ucandevices/IO-LINK-Covnerter/pcb/IO_link.png

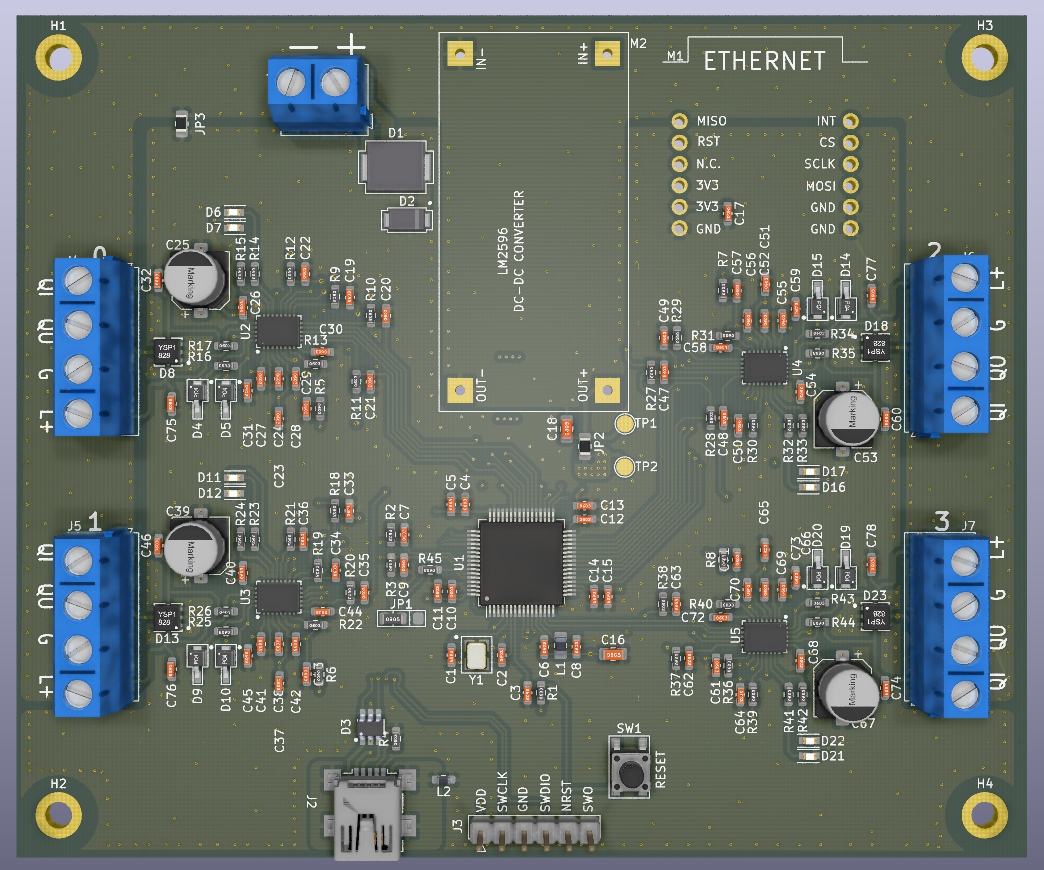
pcb/IO_link.png
