ucandevices/IO-LINK-Covnerter/firmware/IOLINK_MASTER/README.md

# IO-LINK_TEST

'0' - reset all devices
'1' - SIO dev 0
'2' - IO-LINK dev 0
'3' - SIO dev 1
'4' - IO-LINK dev 1
...
'8' - IO-LINK dev 3
other - reset STM

Przykład widoku konsoli dla '8':
                                                                                
Start Program                                                                   

Power up dev 3 CORRECT                                                          
Wake up dev 3 CORRECT - BAUD 2                                                  
-----Car$l!o Gav6azzi"?-                                                        
INIT DEV 3 DONE                                                                 
                                                                                
--------------------------------<<<<<<<<<<<<<<<-------------------              
                                                                       
,gdzie - to czujnik bez kontaktu, < przyłożone coś do czujnika
