ucandevices/IO-LINK-Covnerter/pcb/IO_LINK_LIB/STEP_FILES/Ferrite_Bead_0603.STEP

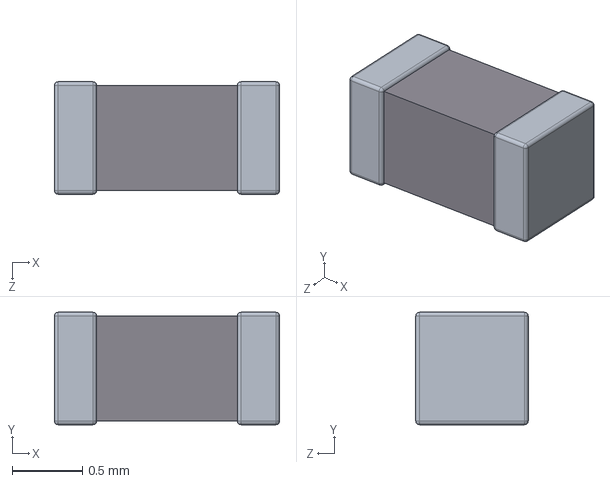
[picture p2: CAD file, 2021-03-06]
pcb/IO_LINK_LIB/STEP_FILES/Ferrite_Bead_0603.STEP
1.60 x 0.8 x 0.8 mm
