ucandevices/IO-LINK-Covnerter/pcb/IO_LINK_LIB/STEP_FILES/Coilcraft-MSS1210.step

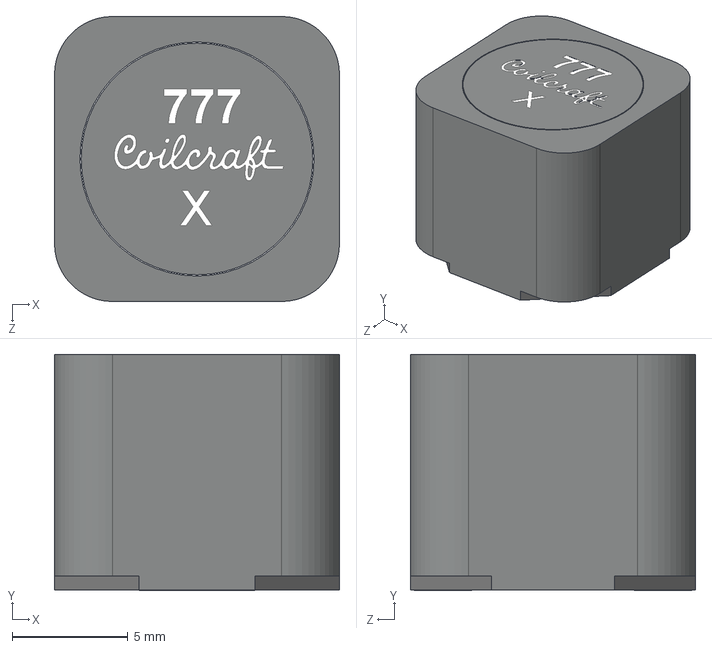
[picture p3: CAD file, 2021-03-06]
pcb/IO_LINK_LIB/STEP_FILES/Coilcraft-MSS1210.step
12.3 x 10.2 x 12.3 mm
