ucandevices/IO-LINK-Covnerter/pcb/IO_LINK_LIB/STEP_FILES/Resistor_0603.step

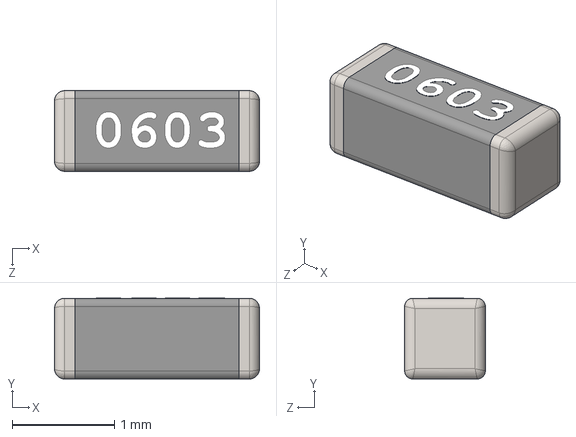
[picture p4: CAD file, 2021-03-06]
pcb/IO_LINK_LIB/STEP_FILES/Resistor_0603.step
2.00 x 0.79 x 0.787 mm
