ucandevices/IO-LINK-Covnerter/pcb/IO_LINK_LIB/STEP_FILES/SPT01-335DEE.step

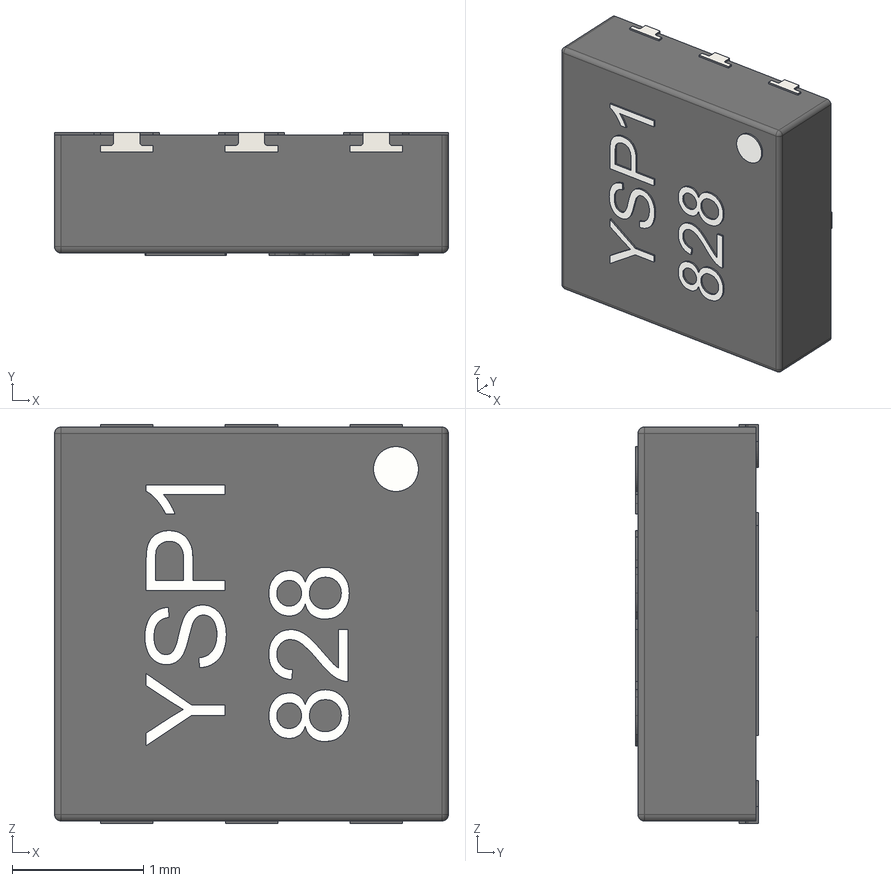
[picture p5: CAD file, 2021-03-06]
pcb/IO_LINK_LIB/STEP_FILES/SPT01-335DEE.step
3.00 x 0.94 x 3.04 mm
