ucandevices/IO-LINK-Covnerter/pcb/IO_LINK_LIB/STEP_FILES/IDC_20.step

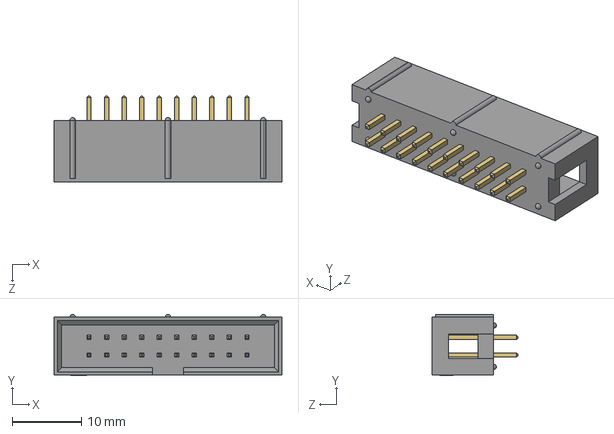
[picture p6: CAD file, 2021-03-06]
pcb/IO_LINK_LIB/STEP_FILES/IDC_20.step
33.0 x 8.85 x 12.4 mm
