ucandevices/IO-LINK-Covnerter/pcb/IO_LINK_LIB/STEP_FILES/ACT45B.step

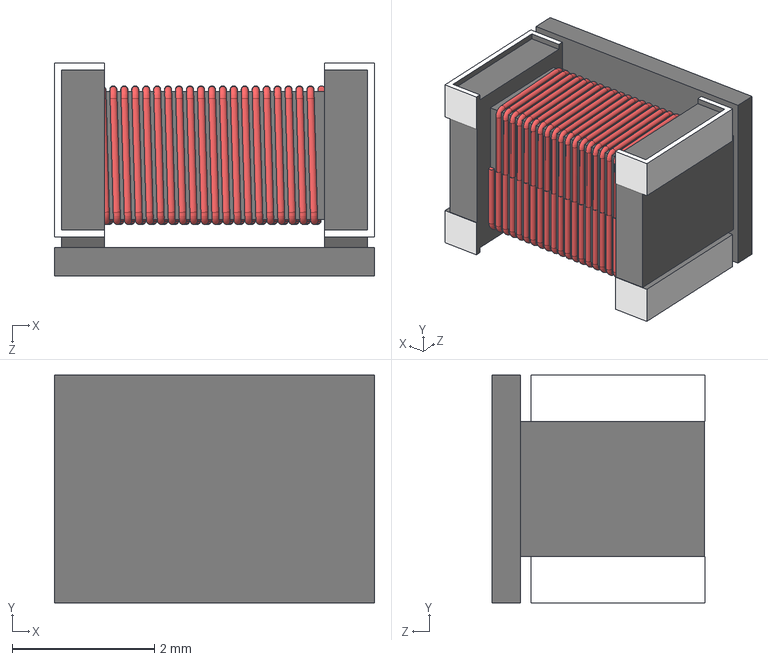
[picture p7: CAD file, 2021-03-06]
pcb/IO_LINK_LIB/STEP_FILES/ACT45B.step
4.50 x 3.20 x 3.00 mm
