ucandevices/IO-LINK-Covnerter/pcb/IO_LINK_LIB/STEP_FILES/WIZNET_W5500.step

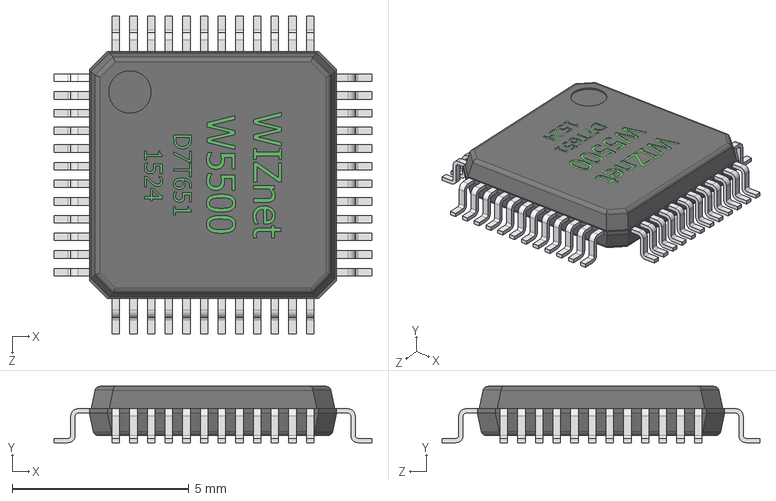
[picture p8: CAD file, 2021-03-06]
pcb/IO_LINK_LIB/STEP_FILES/WIZNET_W5500.step
9.00 x 1.60 x 9.00 mm
