ucandevices/IO-LINK-Covnerter/pcb/IO_LINK_LIB/STEP_FILES/Resistor_1825.step

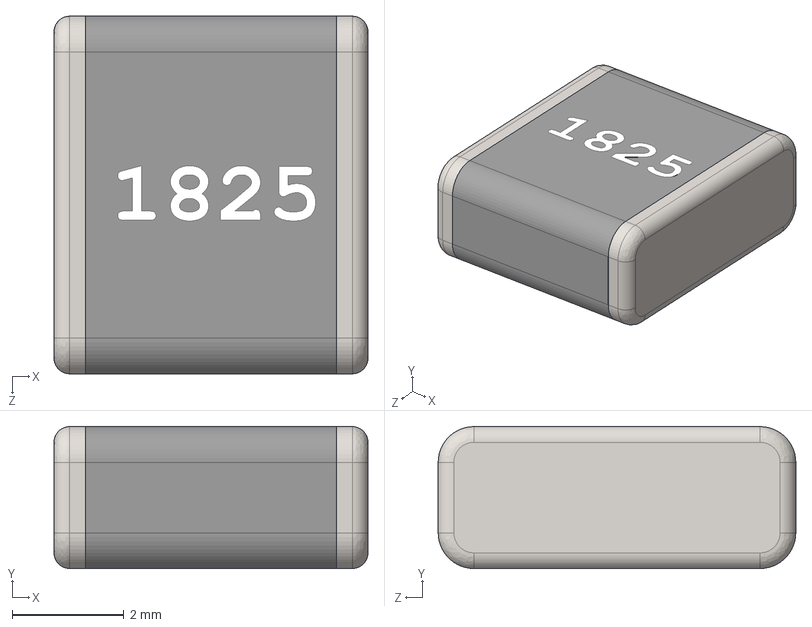
[picture p9: CAD file, 2021-03-06]
pcb/IO_LINK_LIB/STEP_FILES/Resistor_1825.step
5.62 x 2.54 x 6.40 mm
