ucandevices/IO-LINK-Covnerter/pcb/IO_LINK_LIB/STEP_FILES/Resistor_0805.step

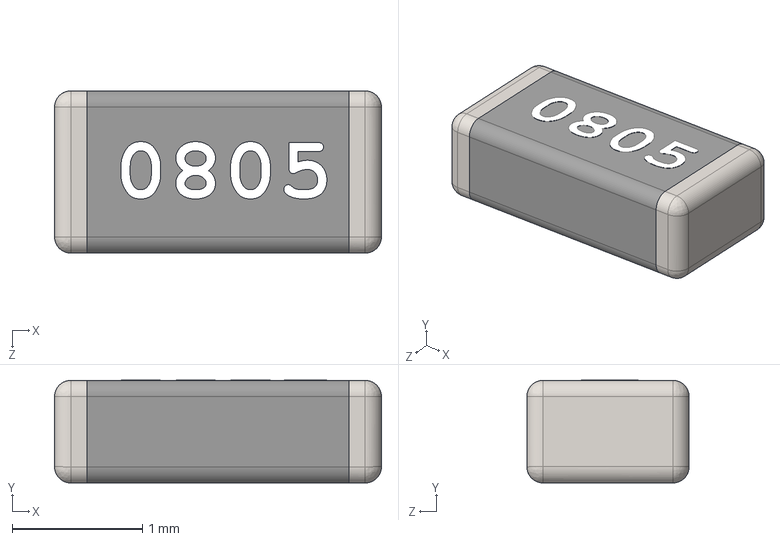
[picture p10: CAD file, 2021-03-06]
pcb/IO_LINK_LIB/STEP_FILES/Resistor_0805.step
2.51 x 0.79 x 1.24 mm
