ucandevices/IO-LINK-Covnerter/pcb/IO_LINK_LIB/STEP_FILES/Tactile_switch.STEP

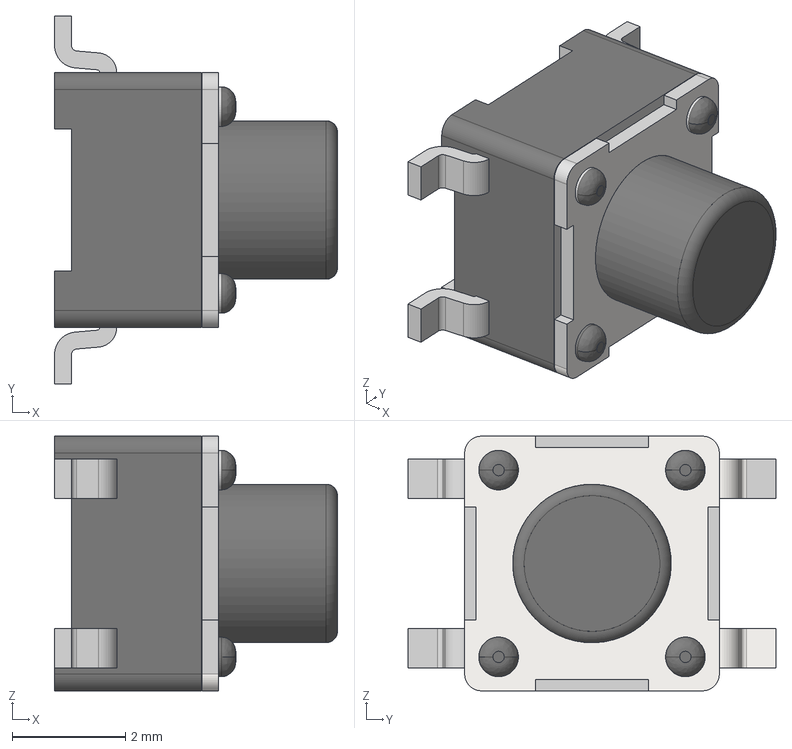
[picture p11: CAD file, 2021-03-06]
pcb/IO_LINK_LIB/STEP_FILES/Tactile_switch.STEP
5.00 x 6.50 x 4.50 mm
