ucandevices/IO-LINK-Covnerter/pcb/IO_LINK_LIB/STEP_FILES/DO-216.step

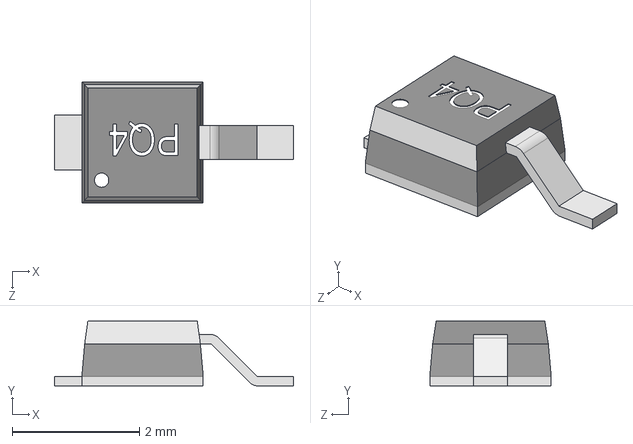
[picture p12: CAD file, 2021-03-06]
pcb/IO_LINK_LIB/STEP_FILES/DO-216.step
3.76 x 1.02 x 1.91 mm
