ucandevices/IO-LINK-Covnerter/pcb/IO_LINK_LIB/STEP_FILES/SO_8.step

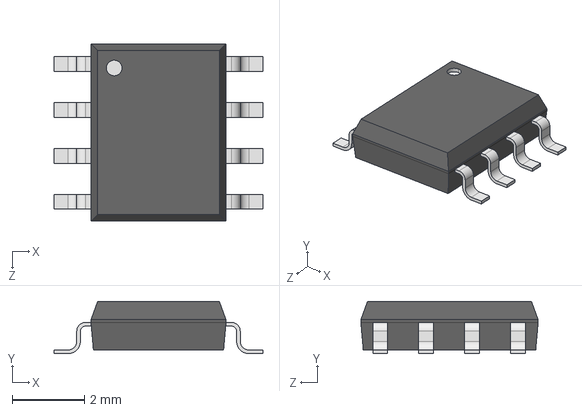
[picture p13: CAD file, 2021-03-06]
pcb/IO_LINK_LIB/STEP_FILES/SO_8.step
5.78 x 1.45 x 4.90 mm
