ucandevices/IO-LINK-Covnerter/pcb/IO_LINK_LIB/STEP_FILES/SMC_DO-214AB_BI_TVS.step

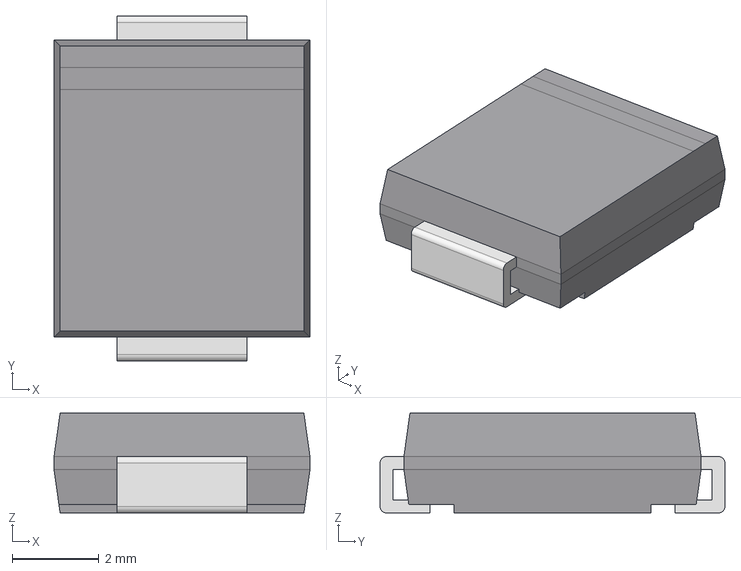
[picture p14: CAD file, 2021-03-06]
pcb/IO_LINK_LIB/STEP_FILES/SMC_DO-214AB_BI_TVS.step
5.90 x 7.95 x 2.30 mm
