ucandevices/IO-LINK-Covnerter/pcb/IO_LINK_LIB/STEP_FILES/COIL_SMD_0805.STEP

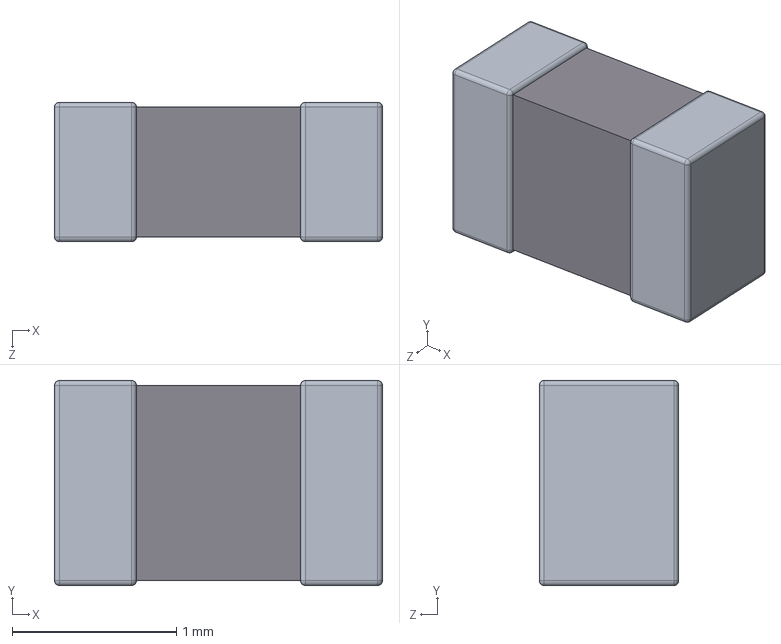
[picture p15: CAD file, 2021-03-06]
pcb/IO_LINK_LIB/STEP_FILES/COIL_SMD_0805.STEP
2.00 x 1.25 x 0.85 mm
