ucandevices/IO-LINK-Covnerter/pcb/IO_LINK_LIB/STEP_FILES/USB_mini_B .step

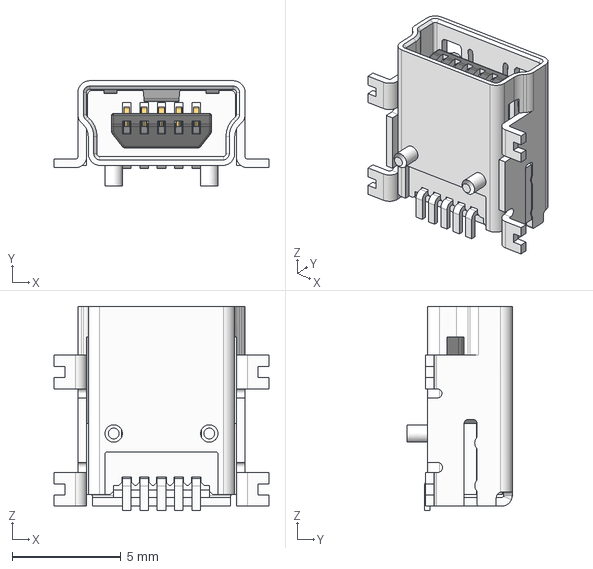
[picture p16: CAD file, 2021-03-06]
pcb/IO_LINK_LIB/STEP_FILES/USB_mini_B .step
9.90 x 5.00 x 9.40 mm
