ucandevices/IO-LINK-Covnerter/pcb/IO_LINK_LIB/STEP_FILES/Crystal_SMD.STEP

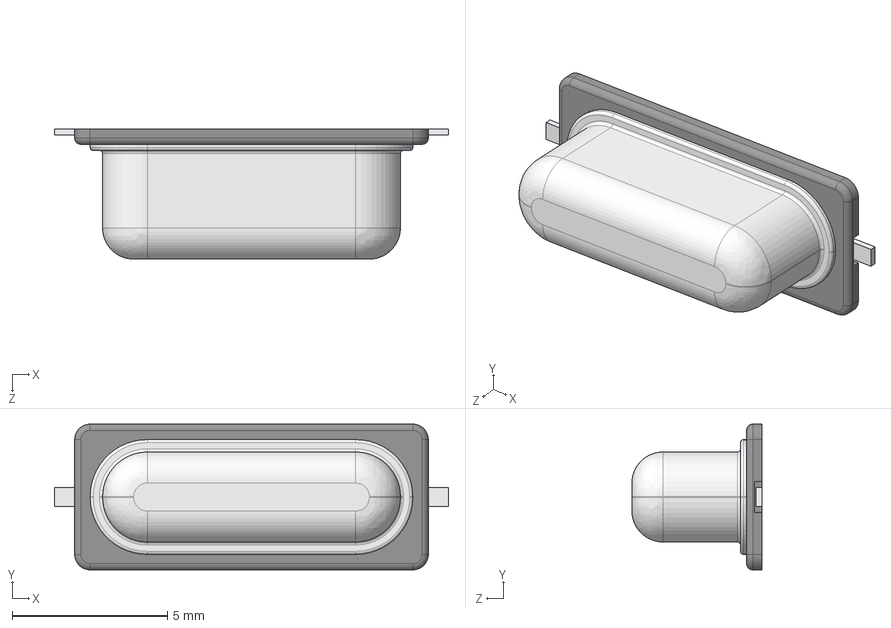
[picture p17: CAD file, 2021-03-06]
pcb/IO_LINK_LIB/STEP_FILES/Crystal_SMD.STEP
12.7 x 4.70 x 4.20 mm
