ucandevices/IO-LINK-Covnerter/pcb/IO_LINK_LIB/STEP_FILES/SOIC_8.step

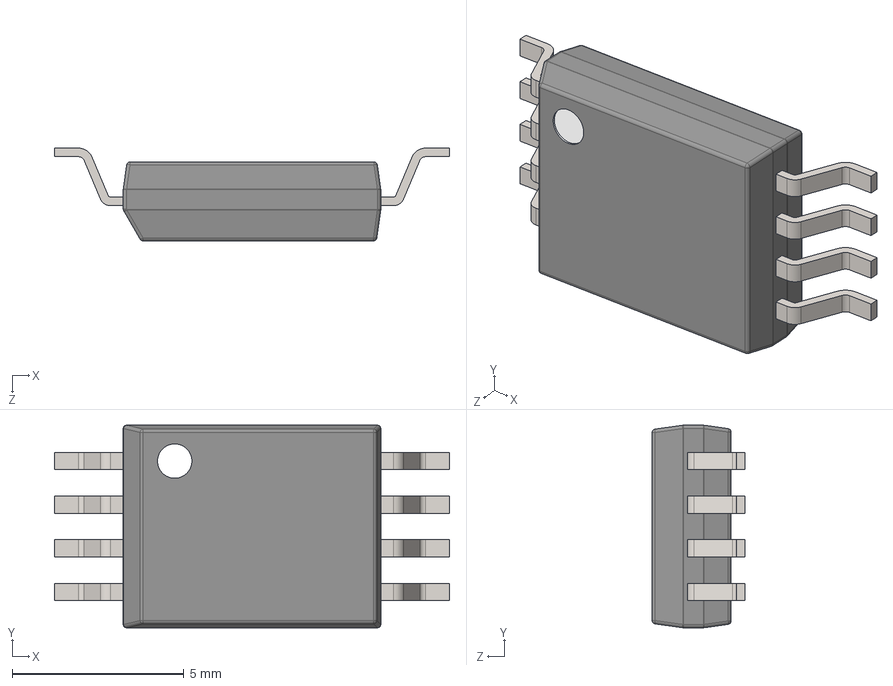
[picture p18: CAD file, 2021-03-06]
pcb/IO_LINK_LIB/STEP_FILES/SOIC_8.step
11.5 x 5.90 x 2.70 mm
