ucandevices/IO-LINK-Covnerter/pcb/IO_LINK_LIB/STEP_FILES/SOT-23-6L.step

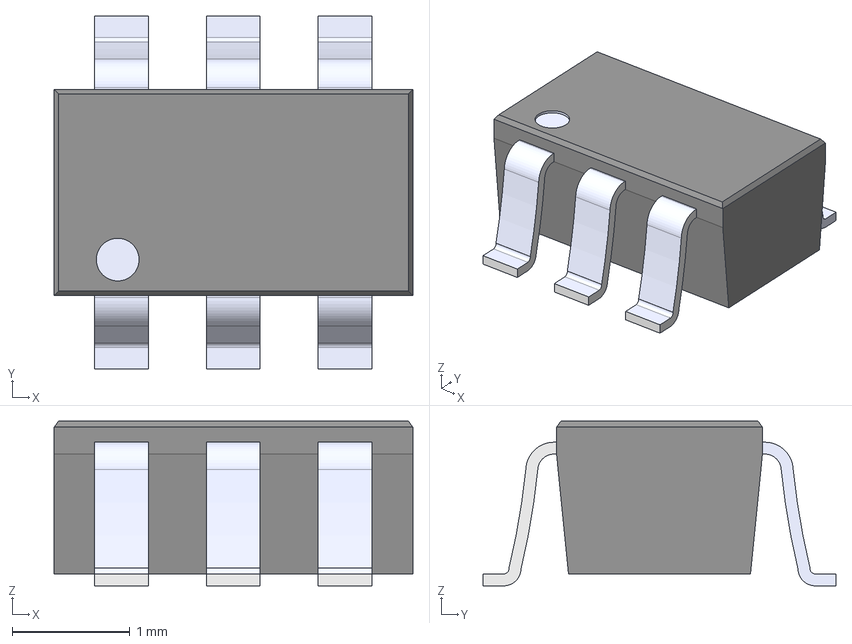
[picture p19: CAD file, 2021-03-06]
pcb/IO_LINK_LIB/STEP_FILES/SOT-23-6L.step
3.05 x 3.00 x 1.40 mm
