ucandevices/IO-LINK-Covnerter/pcb/IO_LINK_LIB/STEP_FILES/SMC_DO-214AB.step

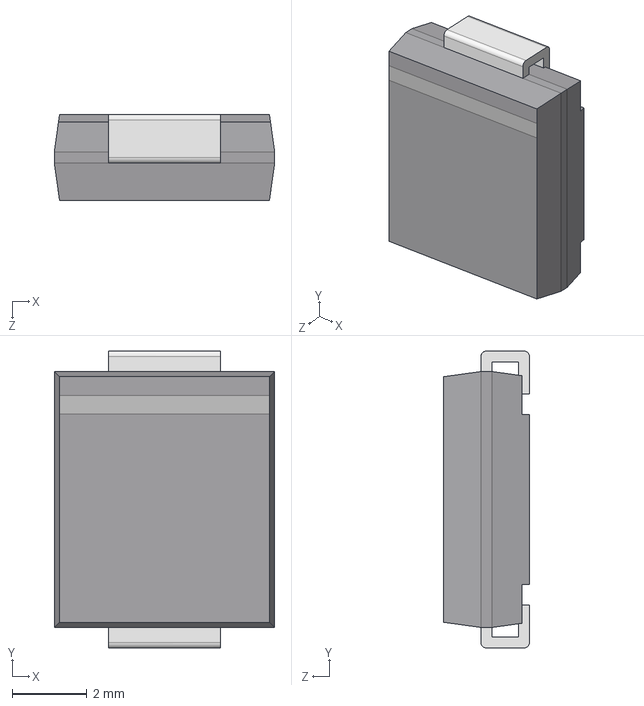
[picture p20: CAD file, 2021-03-06]
pcb/IO_LINK_LIB/STEP_FILES/SMC_DO-214AB.step
5.90 x 7.95 x 2.30 mm
