ucandevices/IO-LINK-Covnerter/pcb/IO_LINK_LIB/STEP_FILES/Electrolytic_Capacitor_6.3mm_x_5.8mm .step

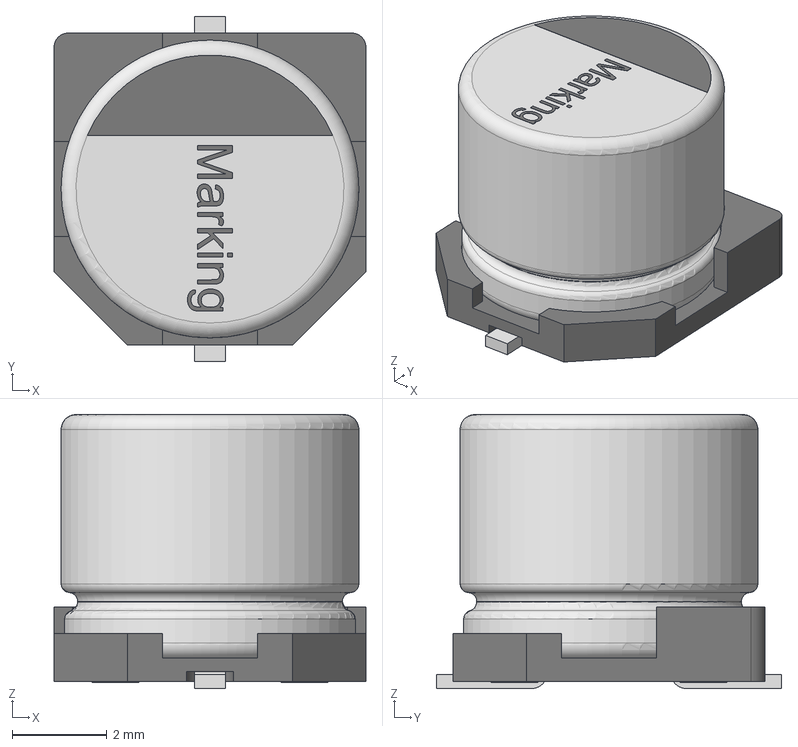
[picture p21: CAD file, 2021-03-06]
pcb/IO_LINK_LIB/STEP_FILES/Electrolytic_Capacitor_6.3mm_x_5.8mm .step
6.60 x 7.30 x 5.81 mm
Base_Φ6_3Capacitor
capicitor_6.3x5.8x2.2
