ucandevices/IO-LINK-Covnerter/pcb/IO_LINK_LIB/STEP_FILES/SOT_23.step

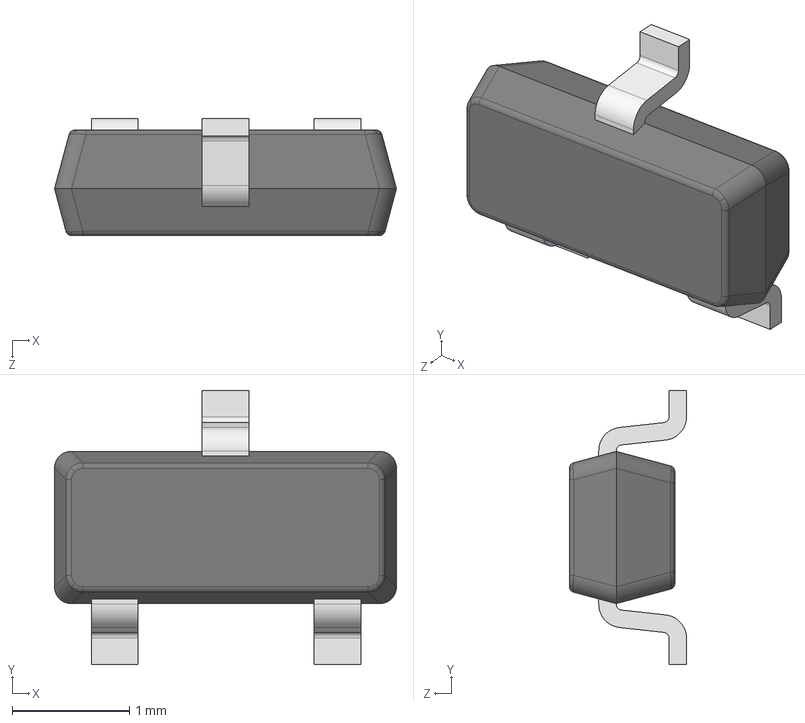
[picture p22: CAD file, 2021-03-06]
pcb/IO_LINK_LIB/STEP_FILES/SOT_23.step
2.92 x 2.34 x 1.00 mm
