ucandevices/IO-LINK-Covnerter/pcb/IO_LINK_LIB/STEP_FILES/Capacitor_1206.step

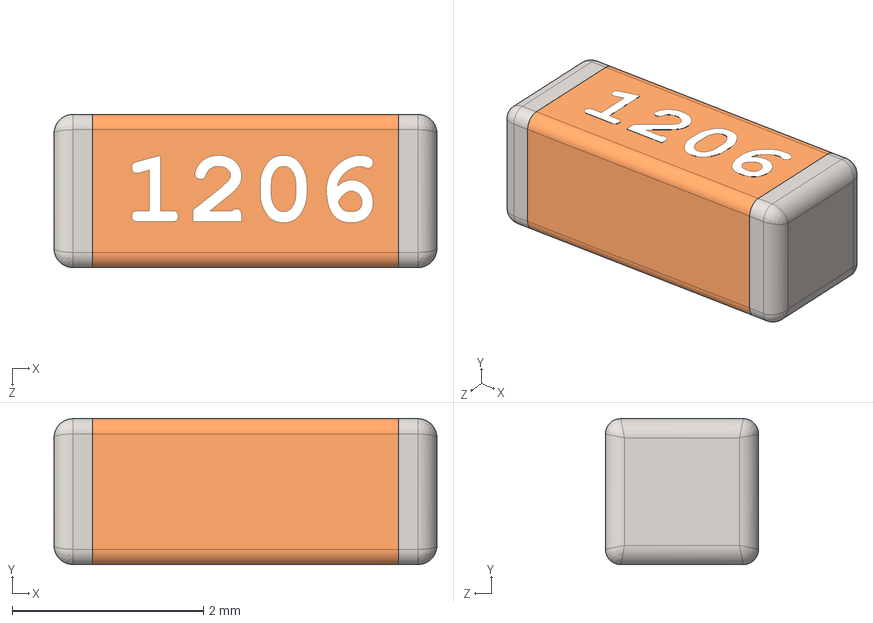
[picture p23: CAD file, 2021-03-06]
pcb/IO_LINK_LIB/STEP_FILES/Capacitor_1206.step
4.00 x 1.53 x 1.60 mm
