ucandevices/IO-LINK-Covnerter/pcb/IO_LINK_LIB/STEP_FILES/SMA_DO214CA.step

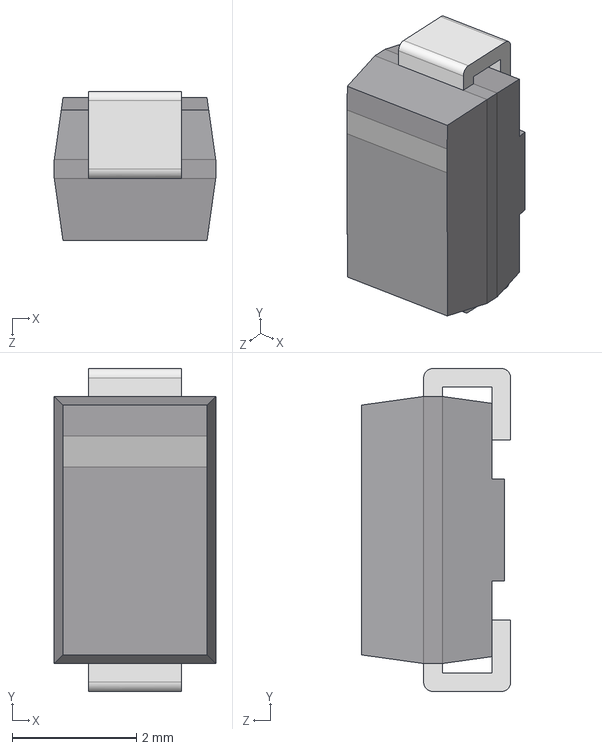
[picture p24: CAD file, 2021-03-06]
pcb/IO_LINK_LIB/STEP_FILES/SMA_DO214CA.step
2.60 x 5.20 x 2.40 mm
