ucandevices/IO-LINK-Covnerter/pcb/IO_LINK_LIB/STEP_FILES/GOLDPIN_1x6_2.54mm.step

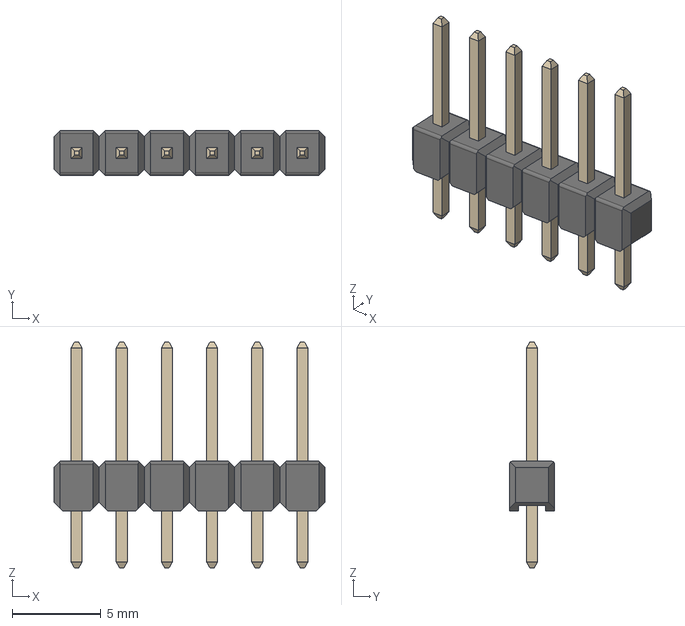
[picture p25: CAD file, 2021-03-06]
pcb/IO_LINK_LIB/STEP_FILES/GOLDPIN_1x6_2.54mm.step
15.2 x 2.54 x 12.7 mm
