ucandevices/IO-LINK-Covnerter/pcb/IO_LINK_LIB/STEP_FILES/LED_0603.step

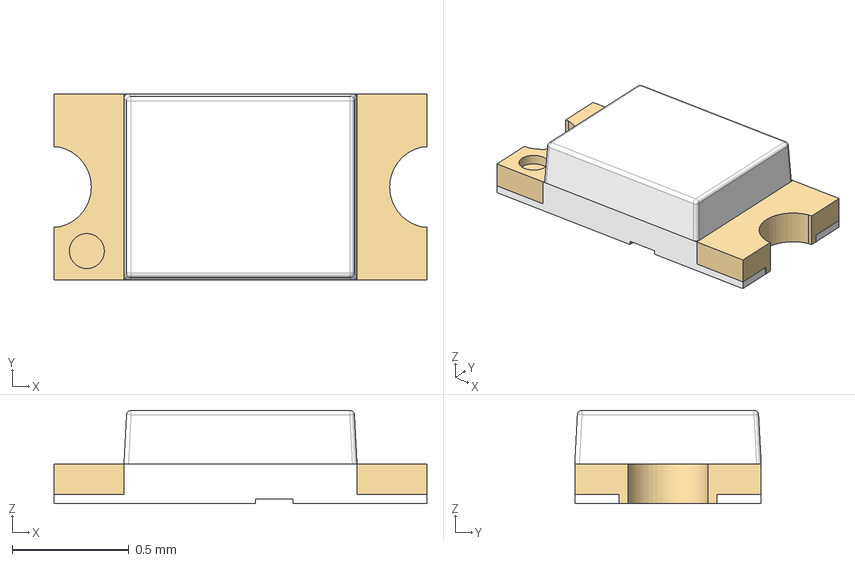
[picture p26: CAD file, 2021-03-06]
pcb/IO_LINK_LIB/STEP_FILES/LED_0603.step
1.60 x 0.8 x 0.4 mm
housing
cover
base-oa0
base
