ucandevices/IO-LINK-Covnerter/pcb/IO_LINK_LIB/STEP_FILES/CRYSTAL_SMD_4pads_3.2x2.5.step

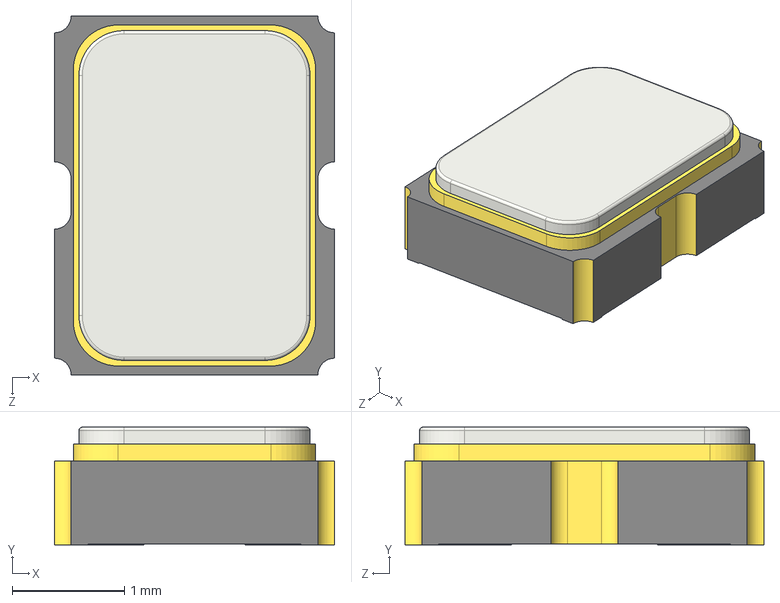
[picture p27: CAD file, 2021-03-06]
pcb/IO_LINK_LIB/STEP_FILES/CRYSTAL_SMD_4pads_3.2x2.5.step
2.50 x 1.05 x 3.20 mm
