ucandevices/IO-LINK-Covnerter/pcb/IO_LINK_LIB/STEP_FILES/L6360TR.step

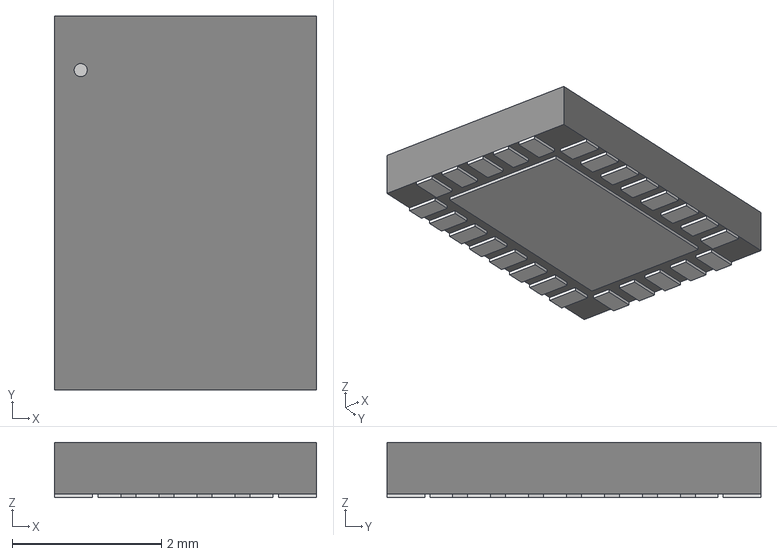
[picture p28: CAD file, 2021-03-06]
pcb/IO_LINK_LIB/STEP_FILES/L6360TR.step
3.51 x 5.00 x 0.739 mm
