ucandevices/IO-LINK-Covnerter/pcb/IO_LINK_LIB/STEP_FILES/HSOP_8.step

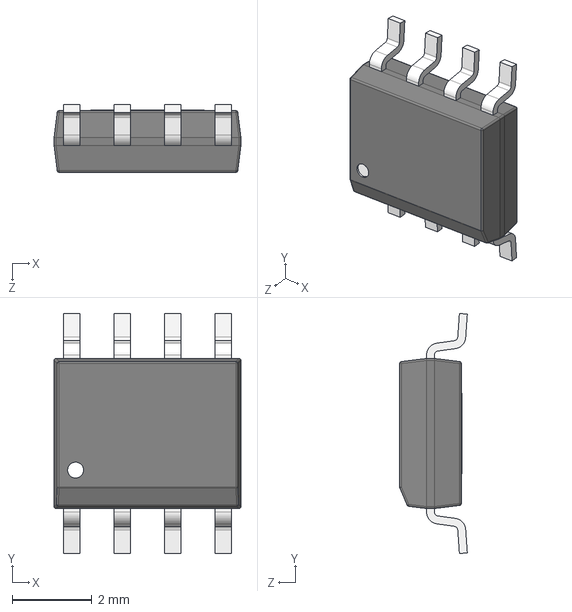
[picture p29: CAD file, 2021-03-06]
pcb/IO_LINK_LIB/STEP_FILES/HSOP_8.step
4.69 x 6.03 x 1.70 mm
