ucandevices/IO-LINK-Covnerter/(list of files, cad)

Other CAD files:
pcb/IO_LINK_LIB/STEP_FILES/Capacitor_0603.step
pcb/IO_LINK_LIB/STEP_FILES/Capacitor_0805.step
pcb/IO_LINK_LIB/STEP_FILES/HR911105A.step
pcb/IO_LINK_LIB/STEP_FILES/Screw_terminal_2way_5.08.step
pcb/IO_LINK_LIB/STEP_FILES/Screw_terminal_3way_5.08.step
pcb/IO_LINK_LIB/STEP_FILES/Screw_terminal_4way_5.step
