ucandevices/IO-LINK-Covnerter/pcb/IO_LINK.kicad_pcb

## KiCad design pcb/IO_LINK.kicad_pcb (2021-06-21)

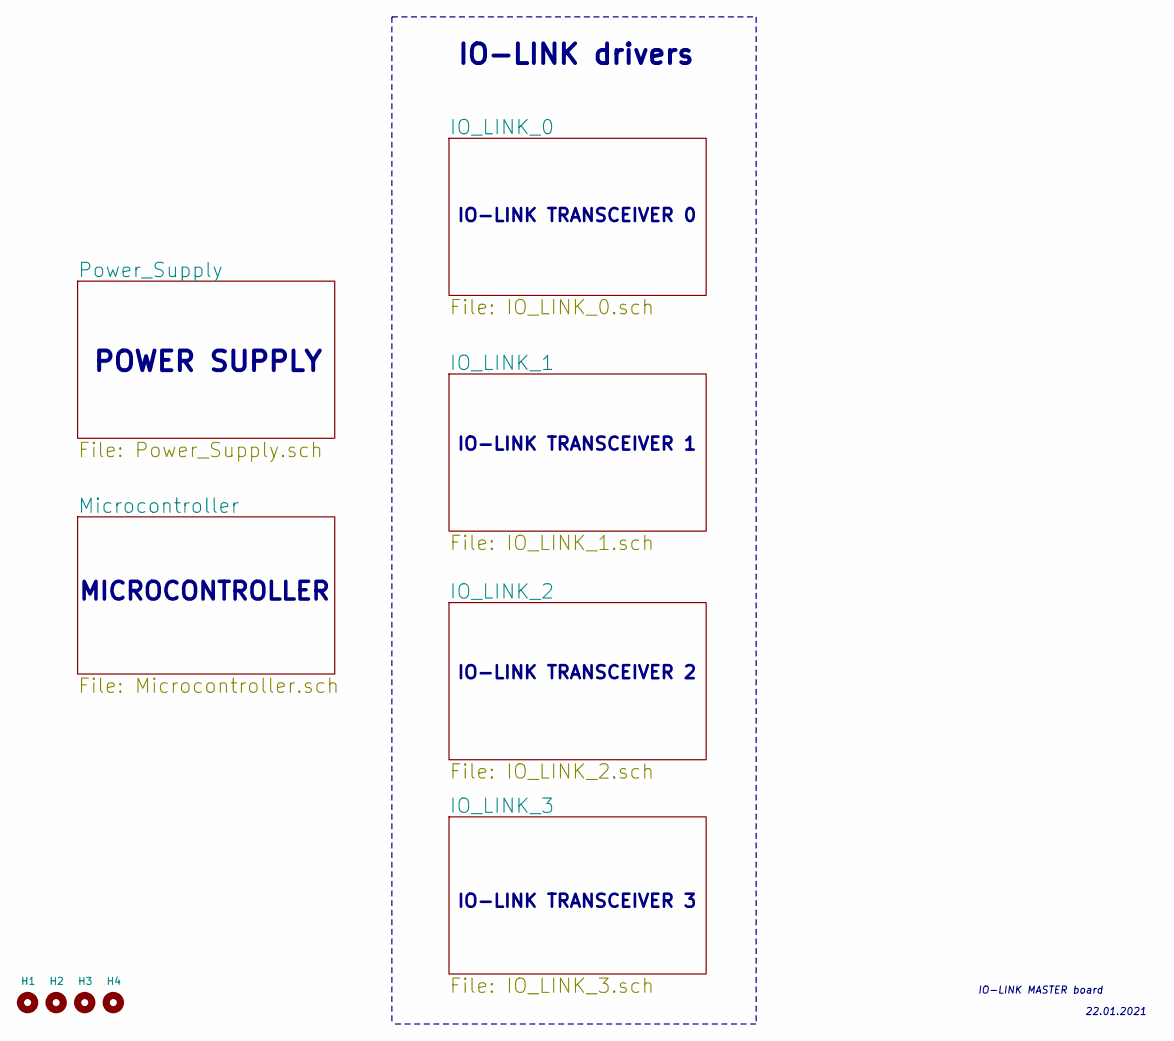
[picture p30: schematic IO_LINK.sch]

Parts:
H1, H2, H3, H4: MountingHole; MountingHole_3.2mm_M3_ISO14580_Pad_TopBottom

Notes on the sheet:
POWER SUPPLY
IO-LINK drivers
MICROCONTROLLER
IO-LINK TRANSCEIVER 0
IO-LINK TRANSCEIVER 1
IO-LINK TRANSCEIVER 2
IO-LINK TRANSCEIVER 3
IO-LINK MASTER board
22.01.2021

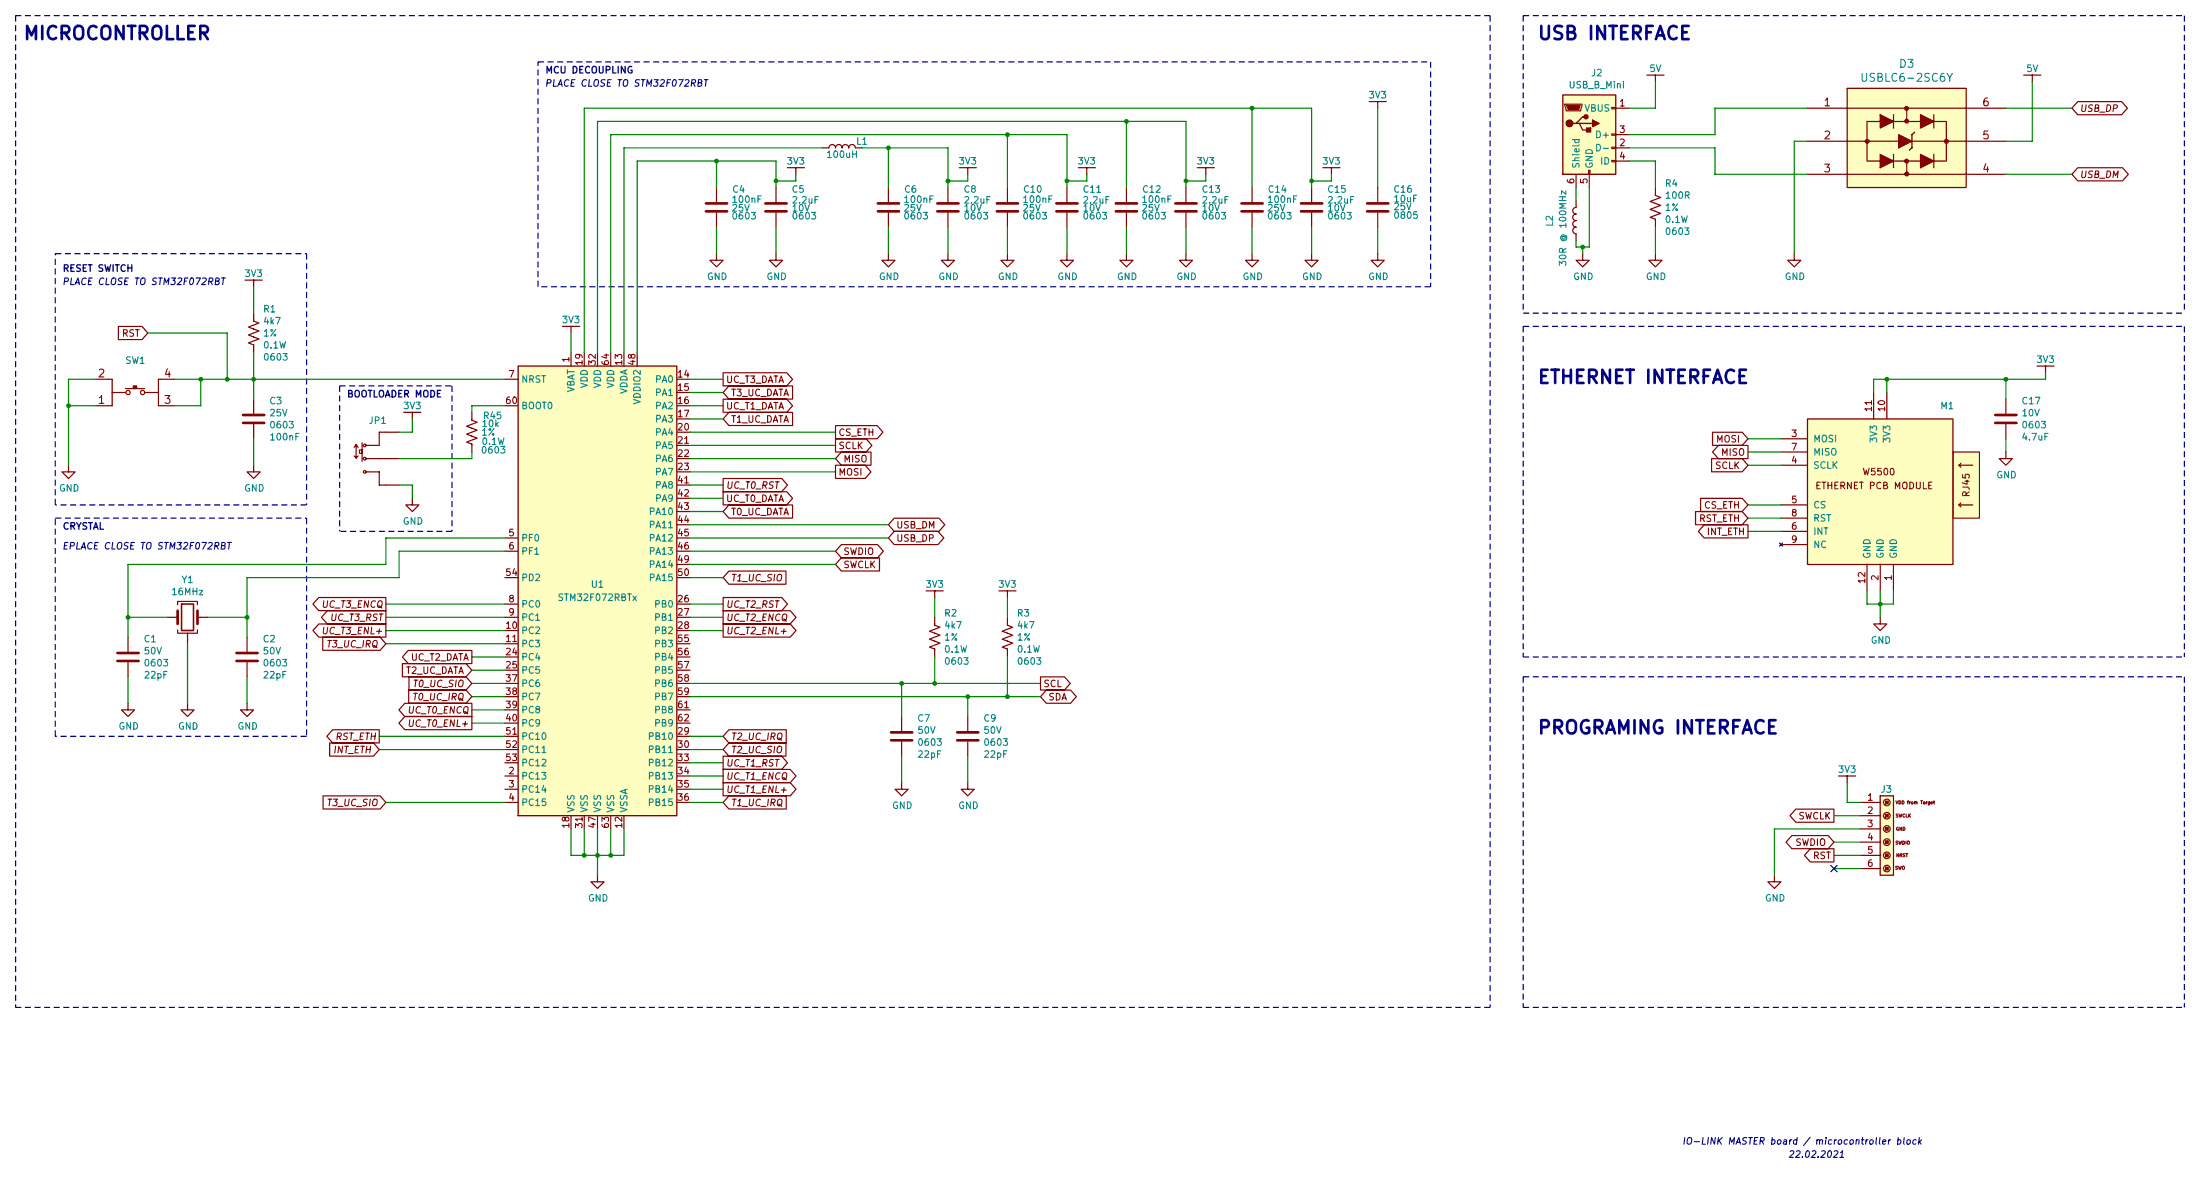
[picture p31: schematic Microcontroller.sch]

Parts:
C1, C2, C7, C9: 22pF_50V_0603; C_0603_1608Metric_Pad1.08x0.95mm_HandSolder; Voltage 50V; MPN CL10C220JB8NNNC; LCSC C1653
C3, C4, C6, C10, C12, C14: 100nF_25V_0603; C_0603_1608Metric_Pad1.08x0.95mm_HandSolder; Voltage 25V; MPN 0603B104K250CT; LCSC C83054
C5, C8, C11, C13, C15: 2.2uF_10V_0603; C_0603_1608Metric_Pad1.08x0.95mm_HandSolder; Voltage 10V; MPN CL10A225KP8NNNC; LCSC C1607
C16: 10uF_25V_0805; C_0805_2012Metric_Pad1.18x1.45mm_HandSolder; Voltage 25V; MPN CL21A106KAYNNNE; LCSC C15850
C17: 4.7uF_10V_0603; C_0603_1608Metric_Pad1.08x0.95mm_HandSolder; Voltage 10V; MPN CL10A475KP8NNNC; LCSC C1705
D3: USBLC6-2SC6Y; SOT-23-6L; MPN USBLC6-2SC6Y; LCSC C435848
J2: USB_B_Mini; USB_Mini-B_Horizontal; MPN 10033526-N3222MLF; LCSC N/A
J3: STM_PROGRAMING_CONNECTOR; MPN T821120A1S100CEU; LCSC N/A
JP1: SOLDERED_SELECTOR; SOLDERABLE_SELECTOR; MPN MCU08050Z0000ZP500; LCSC N/a
L1: Coil_100uH_0805; COIL_0805; MPN KLZ2012NHR101LTD25; LCSC N/A
L2: FB_30R@100MHz; Ferrite_bead_0603; MPN BLM18SP300SZ1D; LCSC N/A
M1: W5500_ETHERNET_PCB_MODULE; W5500_LITE_PCB_MODULE; MPN N/A; LCSC N/A
R1, R2, R3: 4k7_1%_0.1W_0603; R_0603_1608Metric_Pad0.98x0.95mm_HandSolder; Tolerance 1%; MPN 0603WAF4701T5E; LCSC C23162
R4: 100R_1%_0.1W_0603; R_0603_1608Metric_Pad0.98x0.95mm_HandSolder; Tolerance 1%; MPN 0603WAF1000T5E; LCSC C22775
R45: 10k_1%_0.1W_0603; R_0603_1608Metric_Pad0.98x0.95mm_HandSolder; Tolerance 1%; MPN 0603WAF1002T5E; LCSC C25804
SW1: Tactile_Switch; MPN PTS647SN50SMTR2LFS; LCSC N/A
U1: STM32F072RBTx; LQFP-64_10x10mm_P0.5mm
Y1: CRYSTAL_16MHz_4PADS; CRYSTAL_SMD_4PADS_3.2x2.5; MPN X322516MLB4SI; LCSC C13738

Connections:
3V3: C4.1, C5.1, C6.1, C8.1, C10.1, C11.1, C12.1, C13.1, C14.1, C15.1, C16.1, C17.1, J3.1, JP1.1, L1.2, M1.10 (3V3), M1.11 (3V3), R1.1, R2.1, R3.1, U1.1 (VBAT), U1.19 (VDD), U1.32 (VDD), U1.48 (VDDIO2), U1.64 (VDD); also elsewhere on the board
5V: D3.5, J2.1 (VBUS)
CS_ETH: M1.5 (CS), U1.20 (PA4)
GND: C1.2, C2.2, C3.2, C4.2, C5.2, C6.2, C7.2, C8.2, C9.2, C10.2, C11.2, C12.2, C13.2, C14.2, C15.2, C16.2, C17.2, D3.2, J2.5 (GND), J3.3, JP1.3, L2.1, M1.1 (GND), M1.2 (GND), M1.12 (GND), R4.2, SW1.1, SW1.2, U1.12 (VSSA), U1.18 (VSS), U1.31 (VSS), U1.47 (VSS), U1.63 (VSS), Y1.3; also elsewhere on the board
INT_ETH: M1.6 (INT), U1.52 (PC11)
MISO: M1.7 (MISO), U1.22 (PA6)
MOSI: M1.3 (MOSI), U1.23 (PA7)
unnamed: C1.1, U1.5 (PF0), Y1.1
unnamed: C2.1, U1.6 (PF1), Y1.2
unnamed: D3.1 (/IO), J2.3 (D+)
unnamed: D3.3 (2/IO), J2.2 (D-)
unnamed: J2.4 (ID), R4.1
unnamed: J2.6 (Shield), L2.2
unnamed: JP1.2, R45.2
unnamed: L1.1, U1.13 (VDDA)
unnamed: R45.1, U1.60 (BOOT0)
RST: C3.1, J3.5, R1.2, SW1.3, SW1.4, U1.7 (NRST)
RST_ETH: M1.8 (RST), U1.51 (PC10)
SCL: C7.1, R2.2, U1.58 (PB6); also elsewhere on the board
SCLK: M1.4 (SCLK), U1.21 (PA5)
SDA: C9.1, R3.2, U1.59 (PB7); also elsewhere on the board
SWCLK: J3.2, U1.49 (PA14)
SWDIO: J3.4, U1.46 (PA13)
T0_UC_DATA: U1.43 (PA10); also elsewhere on the board
T0_UC_IRQ: U1.38 (PC7); also elsewhere on the board
T0_UC_SIO: U1.37 (PC6); also elsewhere on the board
T1_UC_DATA: U1.17 (PA3); also elsewhere on the board
T1_UC_IRQ: U1.36 (PB15); also elsewhere on the board
T1_UC_SIO: U1.50 (PA15); also elsewhere on the board
T2_UC_DATA: U1.25 (PC5); also elsewhere on the board
T2_UC_IRQ: U1.29 (PB10); also elsewhere on the board
T2_UC_SIO: U1.30 (PB11); also elsewhere on the board
T3_UC_DATA: U1.15 (PA1); also elsewhere on the board
T3_UC_IRQ: U1.11 (PC3); also elsewhere on the board
T3_UC_SIO: U1.4 (PC15); also elsewhere on the board
UC_T0_DATA: U1.42 (PA9); also elsewhere on the board
UC_T0_ENCQ: U1.39 (PC8); also elsewhere on the board
UC_T0_ENL+: U1.40 (PC9); also elsewhere on the board
UC_T0_RST: U1.41 (PA8); also elsewhere on the board
UC_T1_DATA: U1.16 (PA2); also elsewhere on the board
UC_T1_ENCQ: U1.34 (PB13); also elsewhere on the board
UC_T1_ENL+: U1.35 (PB14); also elsewhere on the board
UC_T1_RST: U1.33 (PB12); also elsewhere on the board
UC_T2_DATA: U1.24 (PC4); also elsewhere on the board
UC_T2_ENCQ: U1.27 (PB1); also elsewhere on the board
UC_T2_ENL+: U1.28 (PB2); also elsewhere on the board
UC_T2_RST: U1.26 (PB0); also elsewhere on the board
UC_T3_DATA: U1.14 (PA0); also elsewhere on the board
UC_T3_ENCQ: U1.8 (PC0); also elsewhere on the board
UC_T3_ENL+: U1.10 (PC2); also elsewhere on the board
UC_T3_RST: U1.9 (PC1); also elsewhere on the board
USB_DM: D3.4 (2/IO), U1.44 (PA11)
USB_DP: D3.6 (1/IO), U1.45 (PA12)

Notes on the sheet:
USB INTERFACE
ETHERNET INTERFACE
RESET SWITCH
PROGRAMING INTERFACE
PLACE CLOSE TO STM32F072RBT
EPLACE CLOSE TO STM32F072RBT
CRYSTAL
MCU DECOUPLING
BOOTLOADER MODE
MICROCONTROLLER
IO-LINK MASTER board / microcontroller block
22.02.2021

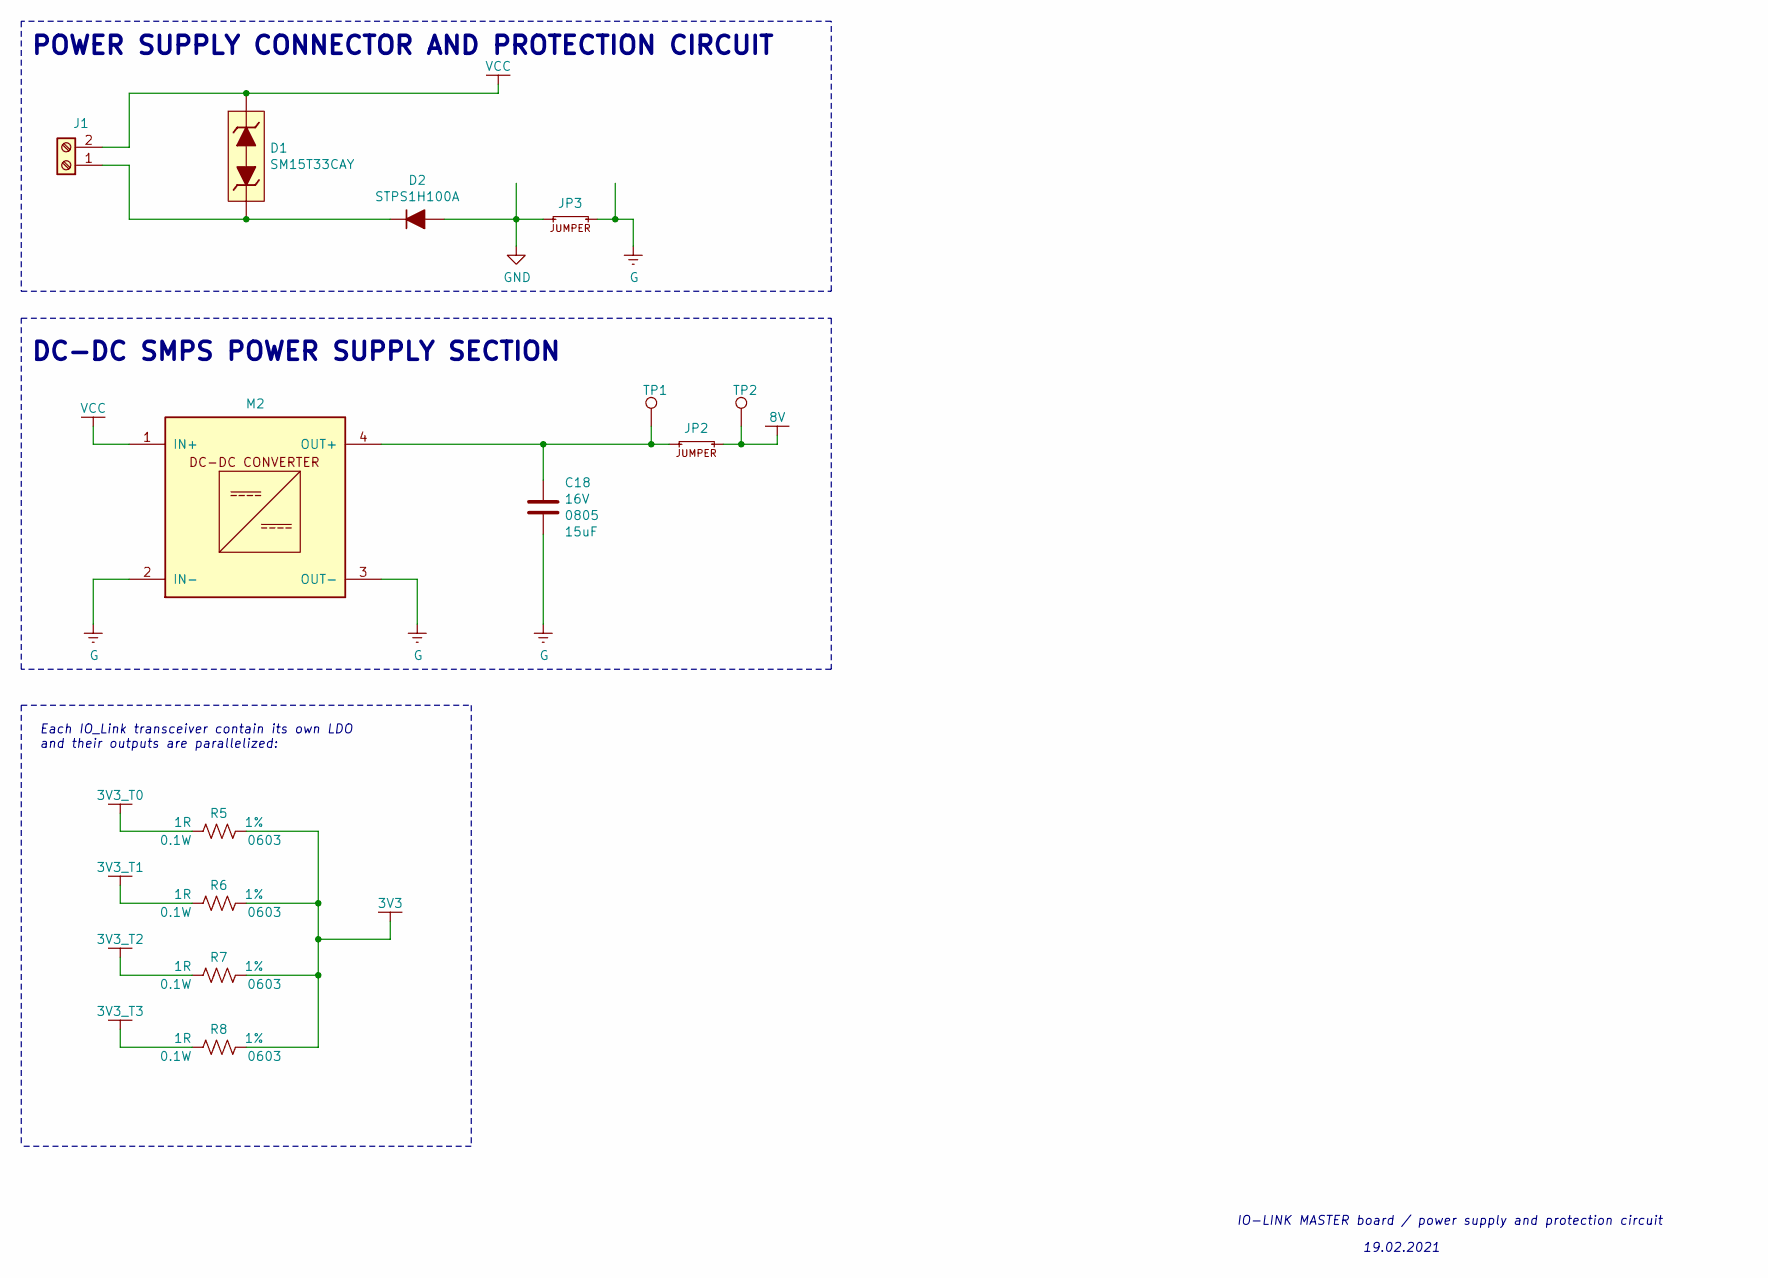
[picture p32: schematic Power_Supply.sch]

Parts:
C18: 15uF_16V_0805; C_0805_2012Metric_Pad1.18x1.45mm_HandSolder; Voltage 16V; MPN C2012JB1C156M125AC; LCSC N/A
D1: SM15T33CAY; SMC_BI_TVS; MPN SM15T33CAY; LCSC N/A
D2: STPS1H100A; SMA; MPN STPS1H100A; LCSC N/A
J1: Screw_Terminal_01x02; TerminalBlock_Altech_AK300-2_P5.00mm; MPN 1729128; LCSC N/A
JP2: 0R_1%_0.1W_0805; R_0805_2012Metric_Pad1.20x1.40mm_HandSolder; Tolerance 1%; MPN 0805W8F0000T5E; LCSC C17477
JP3: JUMPER_0805; R_0805_2012Metric_Pad1.20x1.40mm_HandSolder; Tolerance 1%; MPN 0805W8F0000T5E; LCSC C17477
M2: DC_DC_CONVERTER_LM2596_PCB_MODULE; MPN N/A; LCSC N/A
R5, R6, R7, R8: 1R_1%_0.1W_0603; R_0603_1608Metric_Pad0.98x0.95mm_HandSolder; Tolerance 1%; MPN 0603WAF100KT5E; LCSC C22936
TP1, TP2: TestPoint; TestPoint_Pad_D2.0mm

Connections:
3V3: R5.2, R6.2, R7.2, R8.2; also elsewhere on the board
3V3_T0: R5.1; also elsewhere on the board
3V3_T1: R6.1; also elsewhere on the board
3V3_T2: R7.1; also elsewhere on the board
3V3_T3: R8.1; also elsewhere on the board
8V: JP2.2, TP2.1; also elsewhere on the board
G: C18.2, JP3.2, M2.2 (IN-), M2.3 (OUT-); also elsewhere on the board
GND: D2.2 (A), JP3.1; also elsewhere on the board
unnamed: C18.1, JP2.1, M2.4 (OUT+), TP1.1
unnamed: D1.1, D2.1 (K), J1.1
VCC: D1.2, J1.2, M2.1 (IN+); also elsewhere on the board

Notes on the sheet:
POWER SUPPLY CONNECTOR AND PROTECTION CIRCUIT
IO-LINK MASTER board / power supply and protection circuit
19.02.2021
DC-DC SMPS POWER SUPPLY SECTION
Each IO_Link transceiver contain its own LDO and their outputs are parallelized:

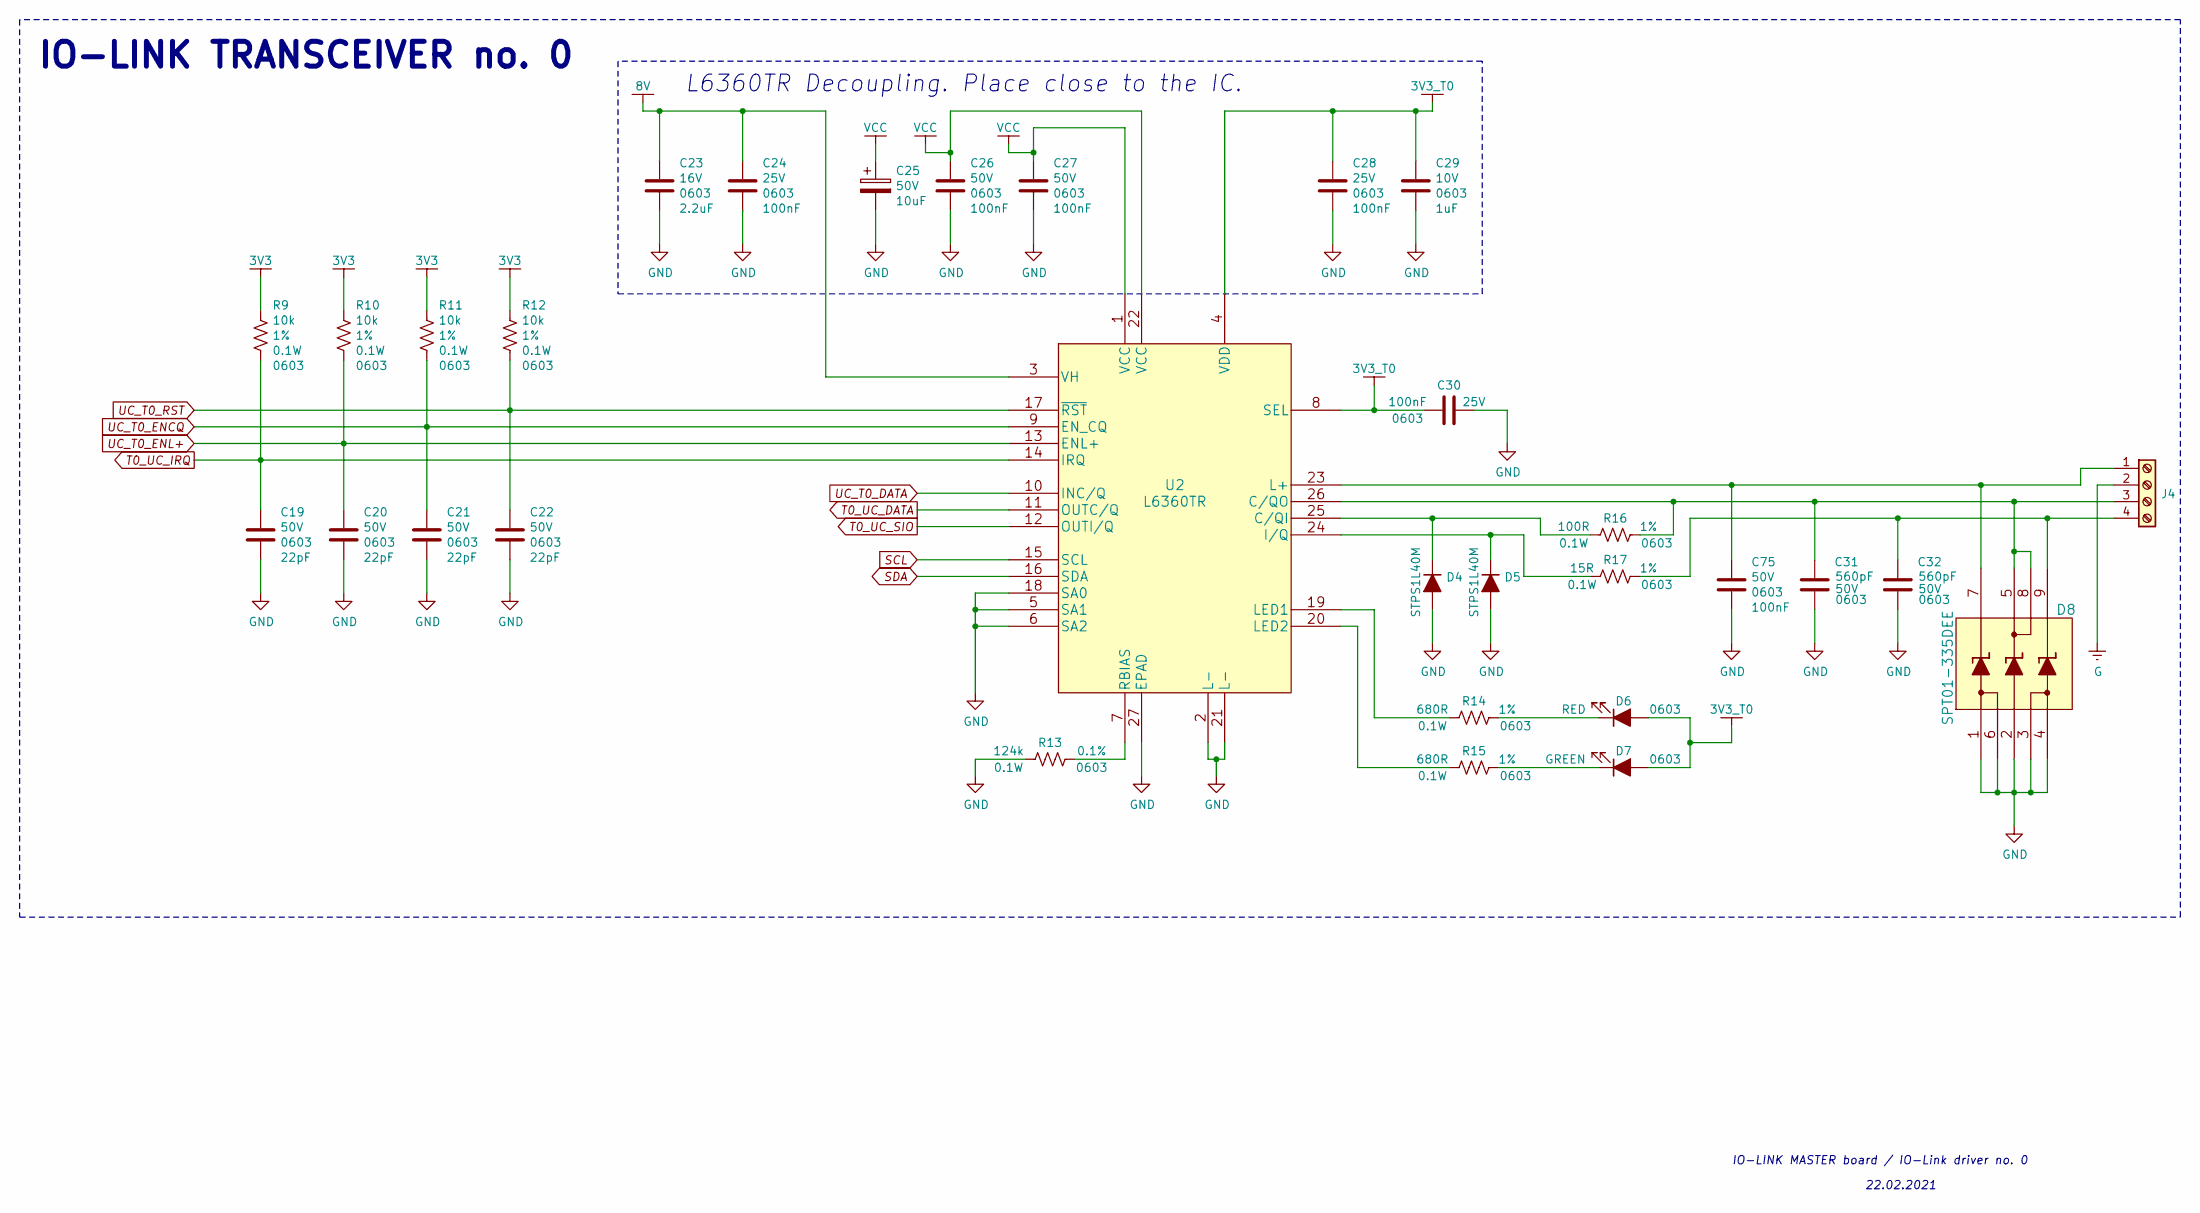
[picture p33: schematic IO_LINK_0.sch]

Parts:
C19, C20, C21, C22: 22pF_50V_0603; C_0603_1608Metric_Pad1.08x0.95mm_HandSolder; Voltage 50V; MPN CL10C220JB8NNNC; LCSC C1653
C23: 2.2uF_16V_0603; C_0603_1608Metric_Pad1.08x0.95mm_HandSolder; Voltage 16V; MPN CL10A225KO8NNNC; LCSC C23630
C24, C28, C30: 100nF_25V_0603; C_0603_1608Metric_Pad1.08x0.95mm_HandSolder; Voltage 25V; MPN 0603B104K250CT; LCSC C83054
C25: 10uF_50V_6.3mm_x_5.8mm_electrolytic; CP_Elec_6.3x5.8; Voltage 50V; MPN VZH100M1HTR-0606; LCSC C249820
C26, C27, C75: 100nF_50V_0603; C_0603_1608Metric_Pad1.08x0.95mm_HandSolder; Voltage 50V; MPN CC0603KRX7R9BB104; LCSC C14663
C29: 1uF_10V_0603; C_0603_1608Metric_Pad1.08x0.95mm_HandSolder; Voltage 10V; MPN CL10B105KP8NNNC; LCSC C95843
C31, C32: 560pF_50V_0603; C_0603_1608Metric_Pad1.08x0.95mm_HandSolder; Voltage 50V; MPN CL10B561KB8NNNC; LCSC C84721
D4, D5: STPS1L40M; DO-216; MPN STPS1L40M; LCSC N/A
D6: LED_RED; LED_0603; MPN 150060RS55040; LCSC N/A
D7: LED_GREEN; LED_0603; MPN 150060VS55040; LCSC N/A
D8: SPT01-335DEE; MPN SPT01-335DEE; LCSC N/A
J4: Screw_Terminal_01x04; TerminalBlock_Altech_AK300-4_P5.00mm; MPN 1715747; LCSC N/A
R9, R10, R11, R12: 10k_1%_0.1W_0603; R_0603_1608Metric_Pad0.98x0.95mm_HandSolder; Tolerance 1%; MPN 0603WAF1002T5E; LCSC C25804
R13: 124k_0.1%_0.1W_0603; R_0603_1608Metric_Pad0.98x0.95mm_HandSolder; Tolerance 0.1%; MPN RG1608P-1243-B-T5; LCSC N/A
R14, R15: 680R_1%_0.1W_0603; R_0603_1608Metric_Pad0.98x0.95mm_HandSolder; Tolerance 1%; MPN 0603WAF6800T5E; LCSC C23228
R16: 100R_1%_0.1W_0603; R_0603_1608Metric_Pad0.98x0.95mm_HandSolder; Tolerance 1%; MPN 0603WAF1000T5E; LCSC C22775
R17: 15R_1%_0.1W_0603; R_0603_1608Metric_Pad0.98x0.95mm_HandSolder; Tolerance 1%; MPN 0603WAF150JT5E; LCSC C22810
U2: L6360TR; MPN L6360TR; LCSC N/A

Connections:
3V3: R9.1, R10.1, R11.1, R12.1; also elsewhere on the board
3V3_T0: C28.1, C29.1, C30.2, D6.2 (A), D7.2 (A), U2.4 (VDD), U2.8 (SEL); also elsewhere on the board
8V: C23.1, C24.1, U2.3 (VH); also elsewhere on the board
G: J4.2; also elsewhere on the board
GND: C19.2, C20.2, C21.2, C22.2, C23.2, C24.2, C25.2, C26.2, C27.2, C28.2, C29.2, C30.1, C31.2, C32.2, C75.2, D4.2 (A), D5.2 (A), D8.1, D8.2, D8.3, D8.4, D8.6, R13.2, U2.2 (L-), U2.5 (SA1), U2.6 (SA2), U2.18 (SA0), U2.21 (L-), U2.27 (EPAD); also elsewhere on the board
unnamed: C31.1, D8.5, D8.8, J4.3, R16.1, U2.26 (C/QO)
unnamed: C32.1, D8.9, J4.4, R17.1
unnamed: C75.1, D8.7, J4.1, U2.23 (L+)
unnamed: D4.1 (K), R16.2, U2.25 (C/QI)
unnamed: D5.1 (K), R17.2, U2.24 (I/Q)
unnamed: D6.1 (K), R14.1
unnamed: D7.1 (K), R15.1
unnamed: R13.1, U2.7 (RBIAS)
unnamed: R14.2, U2.19 (LED1)
unnamed: R15.2, U2.20 (LED2)
SCL: U2.15 (SCL); also elsewhere on the board
SDA: U2.16 (SDA); also elsewhere on the board
T0_UC_DATA: U2.11 (OUTC/Q); also elsewhere on the board
T0_UC_IRQ: C19.1, R9.2, U2.14 (IRQ); also elsewhere on the board
T0_UC_SIO: U2.12 (OUTI/Q); also elsewhere on the board
UC_T0_DATA: U2.10 (INC/Q); also elsewhere on the board
UC_T0_ENCQ: C21.1, R11.2, U2.9 (EN_CQ); also elsewhere on the board
UC_T0_ENL+: C20.1, R10.2, U2.13 (ENL+); also elsewhere on the board
UC_T0_RST: C22.1, R12.2, U2.17 (~RST); also elsewhere on the board
VCC: C25.1, C26.1, C27.1, U2.1 (VCC), U2.22 (VCC); also elsewhere on the board

Notes on the sheet:
L6360TR Decoupling. Place close to the IC.
IO-LINK TRANSCEIVER no. 0
IO-LINK MASTER board / IO-Link driver no. 0
22.02.2021

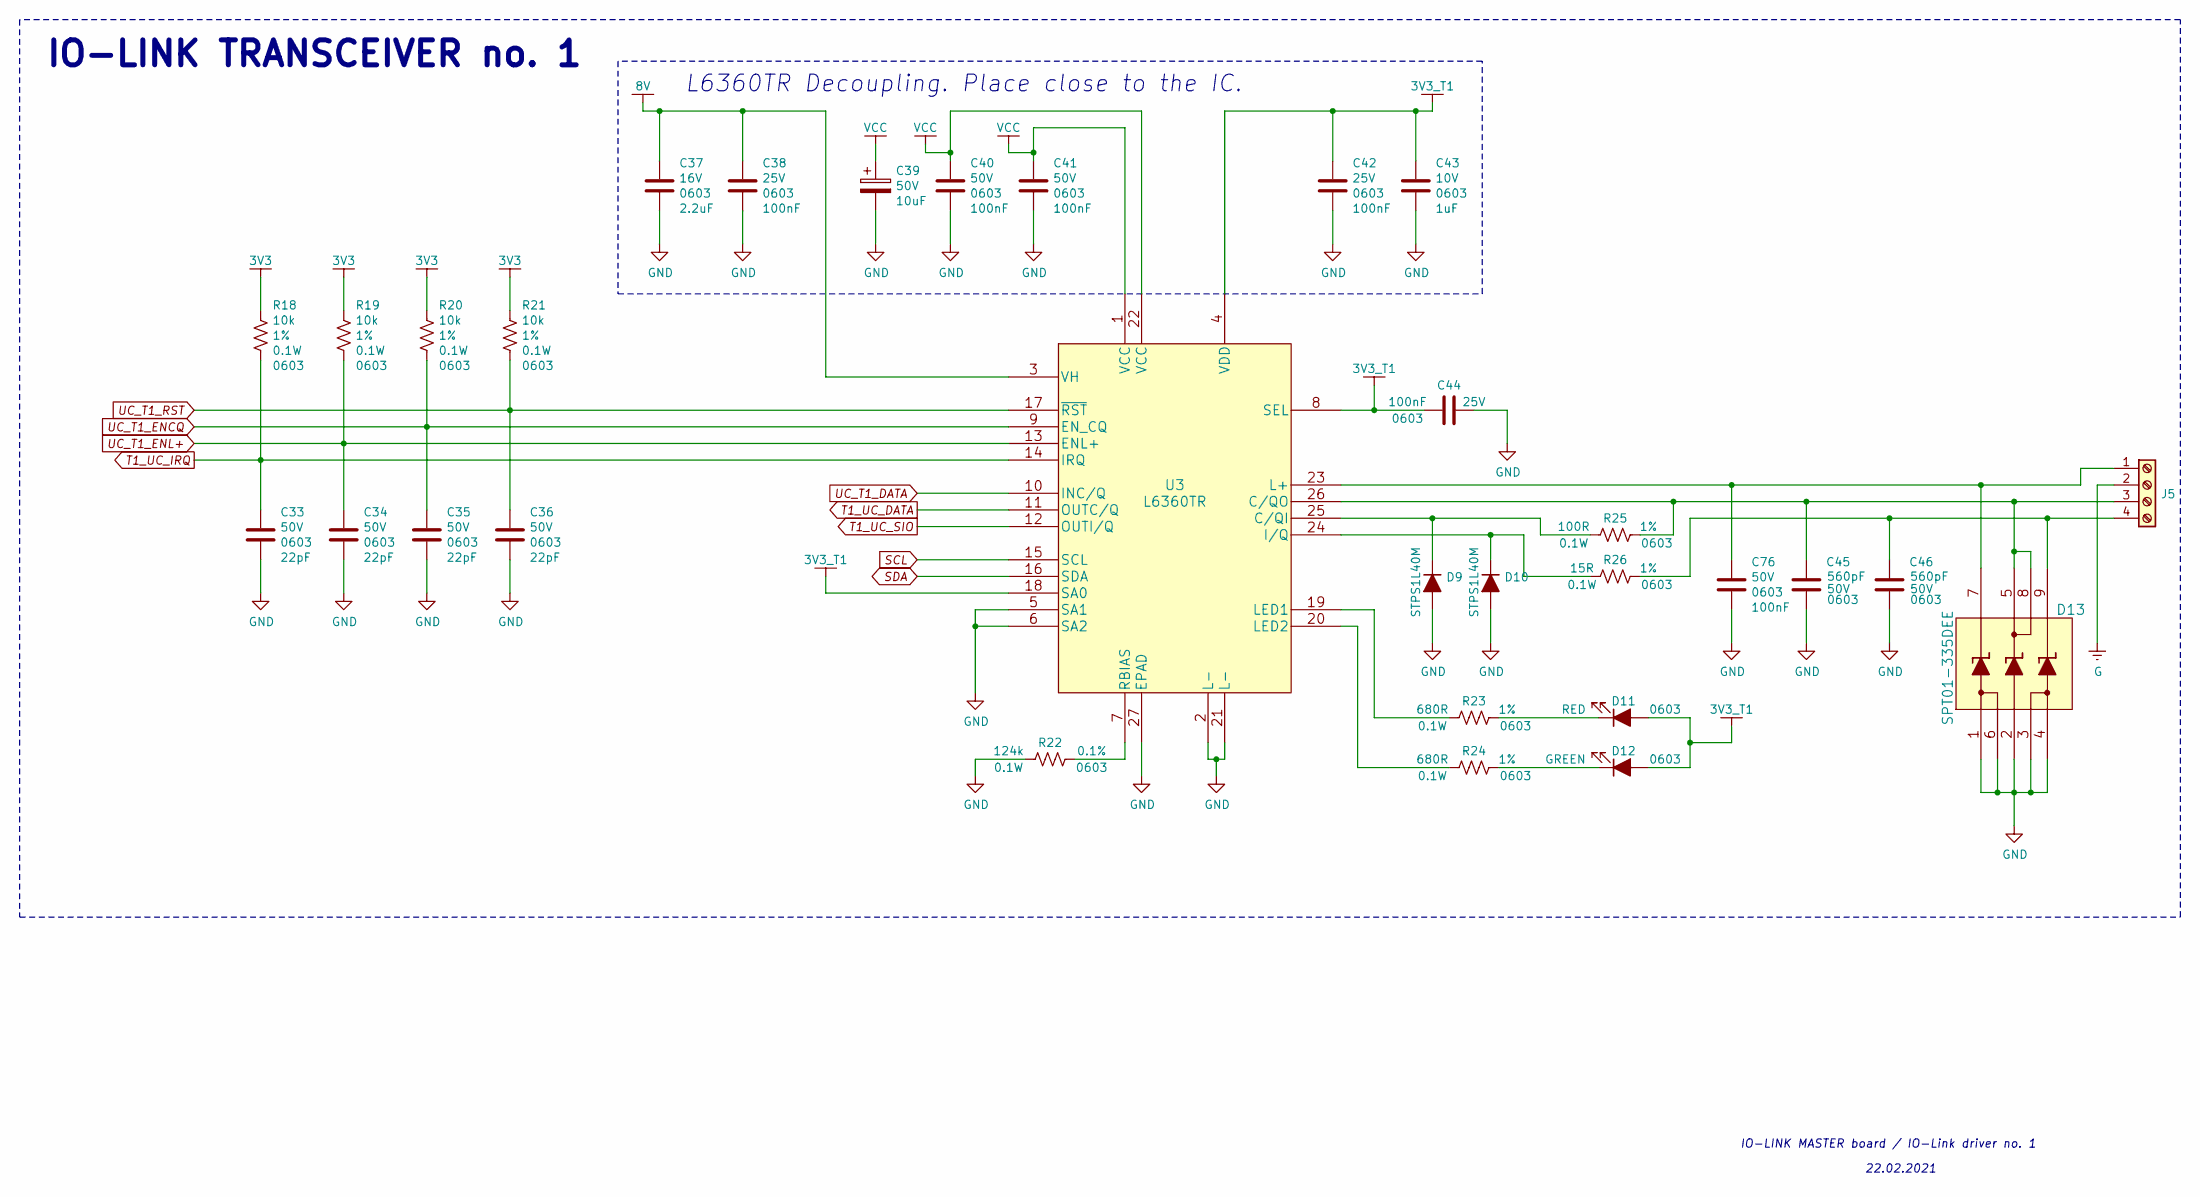
[picture p34: schematic IO_LINK_1.sch]

Parts:
C33, C34, C35, C36: 22pF_50V_0603; C_0603_1608Metric_Pad1.08x0.95mm_HandSolder; Voltage 50V; MPN CL10C220JB8NNNC; LCSC C1653
C37: 2.2uF_16V_0603; C_0603_1608Metric_Pad1.08x0.95mm_HandSolder; Voltage 16V; MPN CL10A225KO8NNNC; LCSC C23630
C38, C42, C44: 100nF_25V_0603; C_0603_1608Metric_Pad1.08x0.95mm_HandSolder; Voltage 25V; MPN 0603B104K250CT; LCSC C83054
C39: 10uF_50V_6.3mm_x_5.8mm_electrolytic; CP_Elec_6.3x5.8; Voltage 50V; MPN VZH100M1HTR-0606; LCSC C249820
C40, C41, C76: 100nF_50V_0603; C_0603_1608Metric_Pad1.08x0.95mm_HandSolder; Voltage 50V; MPN CC0603KRX7R9BB104; LCSC C14663
C43: 1uF_10V_0603; C_0603_1608Metric_Pad1.08x0.95mm_HandSolder; Voltage 10V; MPN CL10B105KP8NNNC; LCSC C95843
C45, C46: 560pF_50V_0603; C_0603_1608Metric_Pad1.08x0.95mm_HandSolder; Voltage 50V; MPN CL10B561KB8NNNC; LCSC C84721
D9, D10: STPS1L40M; DO-216; MPN STPS1L40M; LCSC N/A
D11: LED_RED; LED_0603; MPN 150060RS55040; LCSC N/A
D12: LED_GREEN; LED_0603; MPN 150060VS55040; LCSC N/A
D13: SPT01-335DEE; MPN SPT01-335DEE; LCSC N/A
J5: Screw_Terminal_01x04; TerminalBlock_Altech_AK300-4_P5.00mm; MPN 1715747; LCSC N/A
R18, R19, R20, R21: 10k_1%_0.1W_0603; R_0603_1608Metric_Pad0.98x0.95mm_HandSolder; Tolerance 1%; MPN 0603WAF1002T5E; LCSC C25804
R22: 124k_0.1%_0.1W_0603; R_0603_1608Metric_Pad0.98x0.95mm_HandSolder; Tolerance 0.1%; MPN RG1608P-1243-B-T5; LCSC N/A
R23, R24: 680R_1%_0.1W_0603; R_0603_1608Metric_Pad0.98x0.95mm_HandSolder; Tolerance 1%; MPN 0603WAF6800T5E; LCSC C23228
R25: 100R_1%_0.1W_0603; R_0603_1608Metric_Pad0.98x0.95mm_HandSolder; Tolerance 1%; MPN 0603WAF1000T5E; LCSC C22775
R26: 15R_1%_0.1W_0603; R_0603_1608Metric_Pad0.98x0.95mm_HandSolder; Tolerance 1%; MPN 0603WAF150JT5E; LCSC C22810
U3: L6360TR; MPN L6360TR; LCSC N/A

Connections:
3V3: R18.1, R19.1, R20.1, R21.1; also elsewhere on the board
3V3_T1: C42.1, C43.1, C44.2, D11.2 (A), D12.2 (A), U3.4 (VDD), U3.8 (SEL), U3.18 (SA0); also elsewhere on the board
8V: C37.1, C38.1, U3.3 (VH); also elsewhere on the board
G: J5.2; also elsewhere on the board
GND: C33.2, C34.2, C35.2, C36.2, C37.2, C38.2, C39.2, C40.2, C41.2, C42.2, C43.2, C44.1, C45.2, C46.2, C76.2, D9.2 (A), D10.2 (A), D13.1, D13.2, D13.3, D13.4, D13.6, R22.2, U3.2 (L-), U3.5 (SA1), U3.6 (SA2), U3.21 (L-), U3.27 (EPAD); also elsewhere on the board
unnamed: C45.1, D13.5, D13.8, J5.3, R25.1, U3.26 (C/QO)
unnamed: C46.1, D13.9, J5.4, R26.1
unnamed: C76.1, D13.7, J5.1, U3.23 (L+)
unnamed: D9.1 (K), R25.2, U3.25 (C/QI)
unnamed: D10.1 (K), R26.2, U3.24 (I/Q)
unnamed: D11.1 (K), R23.1
unnamed: D12.1 (K), R24.1
unnamed: R22.1, U3.7 (RBIAS)
unnamed: R23.2, U3.19 (LED1)
unnamed: R24.2, U3.20 (LED2)
SCL: U3.15 (SCL); also elsewhere on the board
SDA: U3.16 (SDA); also elsewhere on the board
T1_UC_DATA: U3.11 (OUTC/Q); also elsewhere on the board
T1_UC_IRQ: C33.1, R18.2, U3.14 (IRQ); also elsewhere on the board
T1_UC_SIO: U3.12 (OUTI/Q); also elsewhere on the board
UC_T1_DATA: U3.10 (INC/Q); also elsewhere on the board
UC_T1_ENCQ: C35.1, R20.2, U3.9 (EN_CQ); also elsewhere on the board
UC_T1_ENL+: C34.1, R19.2, U3.13 (ENL+); also elsewhere on the board
UC_T1_RST: C36.1, R21.2, U3.17 (~RST); also elsewhere on the board
VCC: C39.1, C40.1, C41.1, U3.1 (VCC), U3.22 (VCC); also elsewhere on the board

Notes on the sheet:
L6360TR Decoupling. Place close to the IC.
IO-LINK TRANSCEIVER no. 1
IO-LINK MASTER board / IO-Link driver no. 1
22.02.2021
