ucandevices/IO-LINK-Covnerter/pcb/IO_LINK.kicad_pcb

## KiCad design pcb/IO_LINK.kicad_pcb (continued)

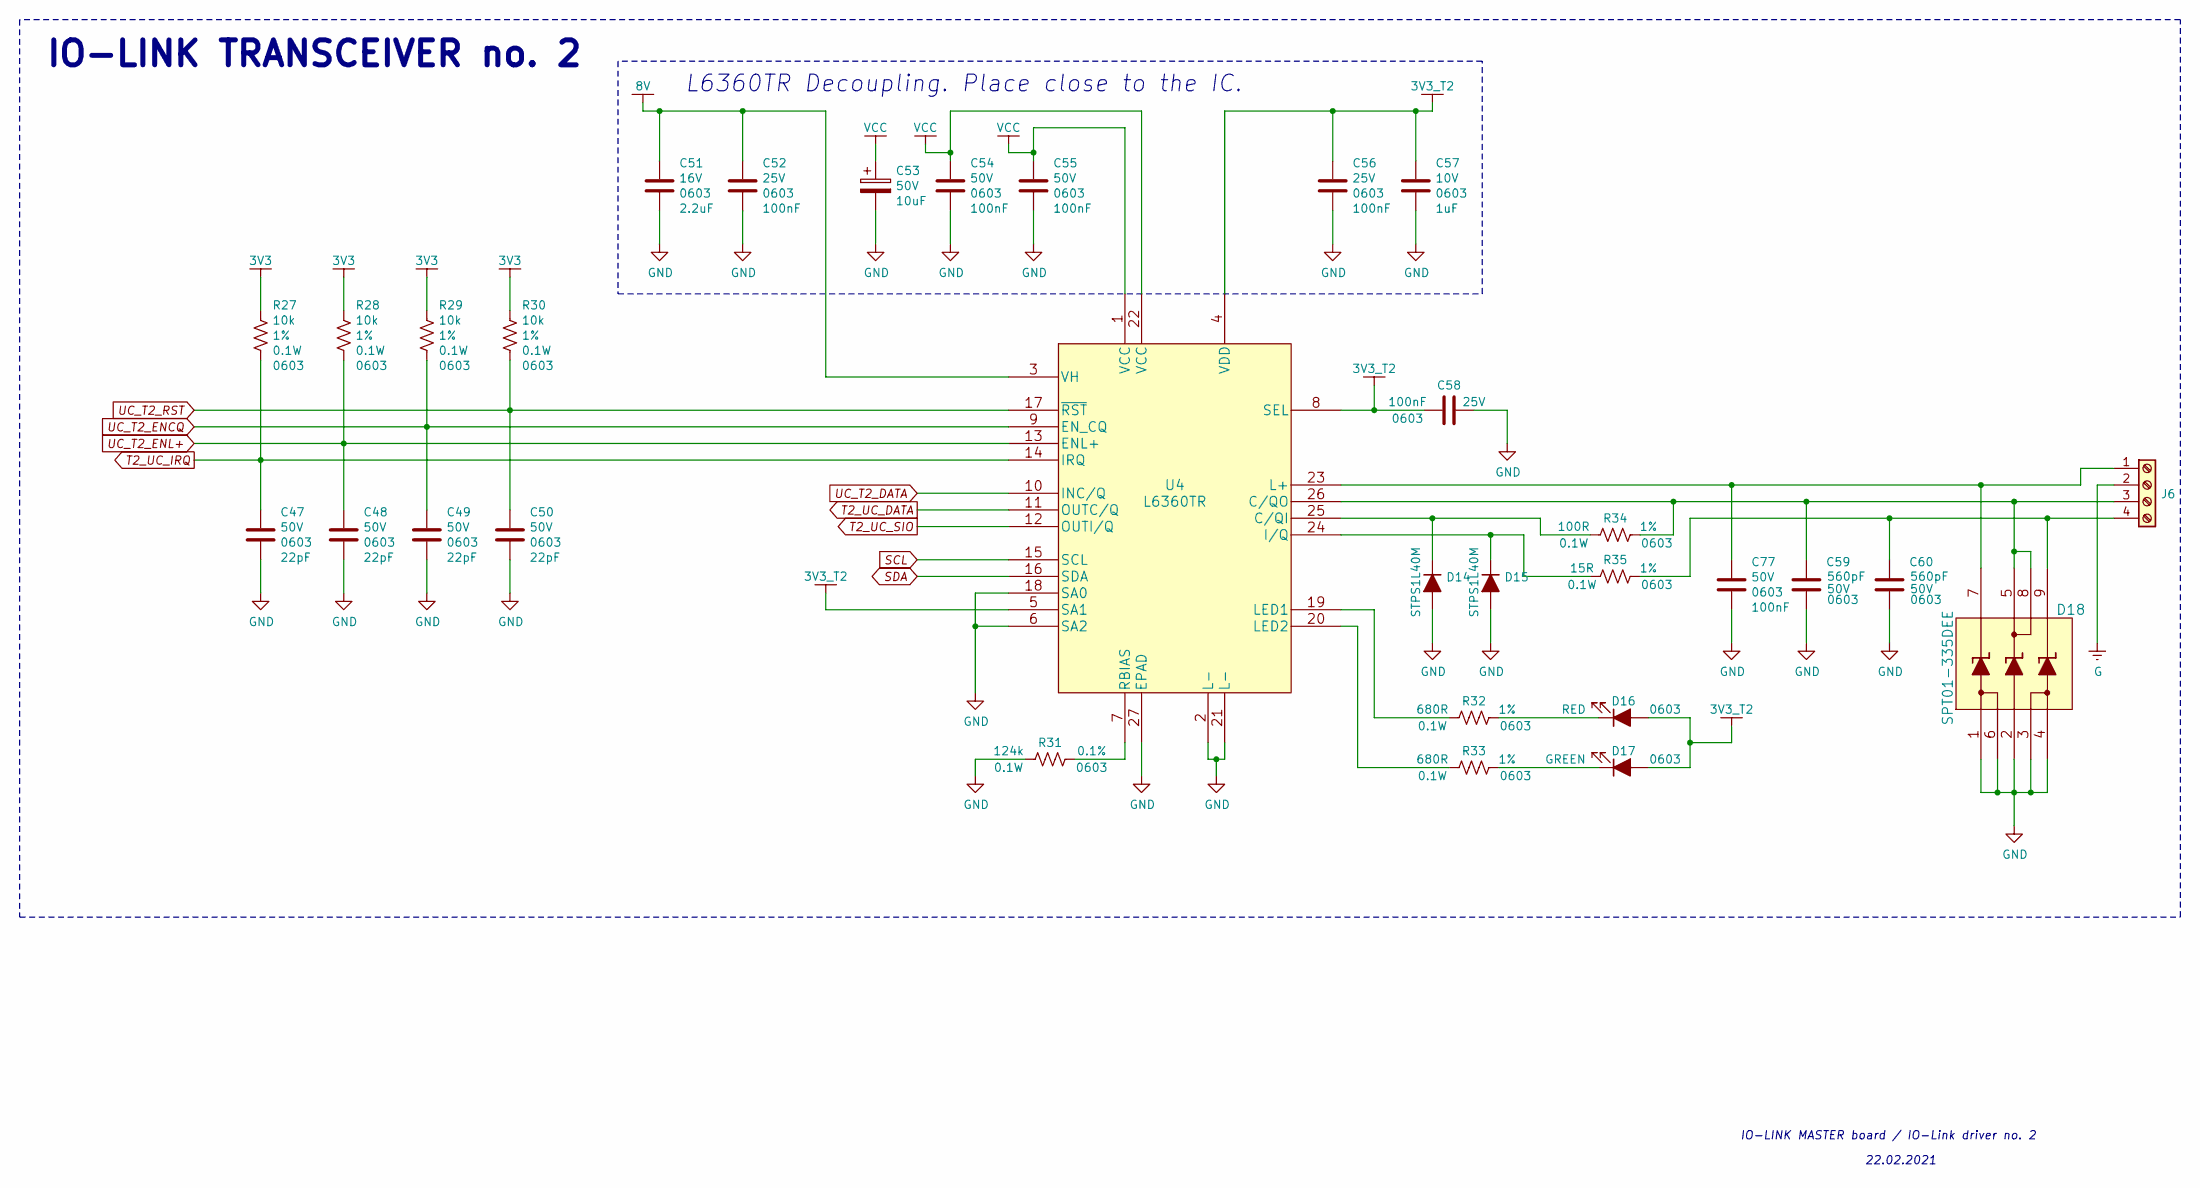
[picture p35: schematic IO_LINK_2.sch]

Parts:
C47, C48, C49, C50: 22pF_50V_0603; C_0603_1608Metric_Pad1.08x0.95mm_HandSolder; Voltage 50V; MPN CL10C220JB8NNNC; LCSC C1653
C51: 2.2uF_16V_0603; C_0603_1608Metric_Pad1.08x0.95mm_HandSolder; Voltage 16V; MPN CL10A225KO8NNNC; LCSC C23630
C52, C56, C58: 100nF_25V_0603; C_0603_1608Metric_Pad1.08x0.95mm_HandSolder; Voltage 25V; MPN 0603B104K250CT; LCSC C83054
C53: 10uF_50V_6.3mm_x_5.8mm_electrolytic; CP_Elec_6.3x5.8; Voltage 50V; MPN VZH100M1HTR-0606; LCSC C249820
C54, C55, C77: 100nF_50V_0603; C_0603_1608Metric_Pad1.08x0.95mm_HandSolder; Voltage 50V; MPN CC0603KRX7R9BB104; LCSC C14663
C57: 1uF_10V_0603; C_0603_1608Metric_Pad1.08x0.95mm_HandSolder; Voltage 10V; MPN CL10B105KP8NNNC; LCSC C95843
C59, C60: 560pF_50V_0603; C_0603_1608Metric_Pad1.08x0.95mm_HandSolder; Voltage 50V; MPN CL10B561KB8NNNC; LCSC C84721
D14, D15: STPS1L40M; DO-216; MPN STPS1L40M; LCSC N/A
D16: LED_RED; LED_0603; MPN 150060RS55040; LCSC N/A
D17: LED_GREEN; LED_0603; MPN 150060VS55040; LCSC N/A
D18: SPT01-335DEE; MPN SPT01-335DEE; LCSC N/A
J6: Screw_Terminal_01x04; TerminalBlock_Altech_AK300-4_P5.00mm; MPN 1715747; LCSC N/A
R27, R28, R29, R30: 10k_1%_0.1W_0603; R_0603_1608Metric_Pad0.98x0.95mm_HandSolder; Tolerance 1%; MPN 0603WAF1002T5E; LCSC C25804
R31: 124k_0.1%_0.1W_0603; R_0603_1608Metric_Pad0.98x0.95mm_HandSolder; Tolerance 0.1%; MPN RG1608P-1243-B-T5; LCSC N/A
R32, R33: 680R_1%_0.1W_0603; R_0603_1608Metric_Pad0.98x0.95mm_HandSolder; Tolerance 1%; MPN 0603WAF6800T5E; LCSC C23228
R34: 100R_1%_0.1W_0603; R_0603_1608Metric_Pad0.98x0.95mm_HandSolder; Tolerance 1%; MPN 0603WAF1000T5E; LCSC C22775
R35: 15R_1%_0.1W_0603; R_0603_1608Metric_Pad0.98x0.95mm_HandSolder; Tolerance 1%; MPN 0603WAF150JT5E; LCSC C22810
U4: L6360TR; MPN L6360TR; LCSC N/A

Connections:
3V3: R27.1, R28.1, R29.1, R30.1; also elsewhere on the board
3V3_T2: C56.1, C57.1, C58.2, D16.2 (A), D17.2 (A), U4.4 (VDD), U4.5 (SA1), U4.8 (SEL); also elsewhere on the board
8V: C51.1, C52.1, U4.3 (VH); also elsewhere on the board
G: J6.2; also elsewhere on the board
GND: C47.2, C48.2, C49.2, C50.2, C51.2, C52.2, C53.2, C54.2, C55.2, C56.2, C57.2, C58.1, C59.2, C60.2, C77.2, D14.2 (A), D15.2 (A), D18.1, D18.2, D18.3, D18.4, D18.6, R31.2, U4.2 (L-), U4.6 (SA2), U4.18 (SA0), U4.21 (L-), U4.27 (EPAD); also elsewhere on the board
unnamed: C59.1, D18.5, D18.8, J6.3, R34.1, U4.26 (C/QO)
unnamed: C60.1, D18.9, J6.4, R35.1
unnamed: C77.1, D18.7, J6.1, U4.23 (L+)
unnamed: D14.1 (K), R34.2, U4.25 (C/QI)
unnamed: D15.1 (K), R35.2, U4.24 (I/Q)
unnamed: D16.1 (K), R32.1
unnamed: D17.1 (K), R33.1
unnamed: R31.1, U4.7 (RBIAS)
unnamed: R32.2, U4.19 (LED1)
unnamed: R33.2, U4.20 (LED2)
SCL: U4.15 (SCL); also elsewhere on the board
SDA: U4.16 (SDA); also elsewhere on the board
T2_UC_DATA: U4.11 (OUTC/Q); also elsewhere on the board
T2_UC_IRQ: C47.1, R27.2, U4.14 (IRQ); also elsewhere on the board
T2_UC_SIO: U4.12 (OUTI/Q); also elsewhere on the board
UC_T2_DATA: U4.10 (INC/Q); also elsewhere on the board
UC_T2_ENCQ: C49.1, R29.2, U4.9 (EN_CQ); also elsewhere on the board
UC_T2_ENL+: C48.1, R28.2, U4.13 (ENL+); also elsewhere on the board
UC_T2_RST: C50.1, R30.2, U4.17 (~RST); also elsewhere on the board
VCC: C53.1, C54.1, C55.1, U4.1 (VCC), U4.22 (VCC); also elsewhere on the board

Notes on the sheet:
L6360TR Decoupling. Place close to the IC.
IO-LINK TRANSCEIVER no. 2
IO-LINK MASTER board / IO-Link driver no. 2
22.02.2021

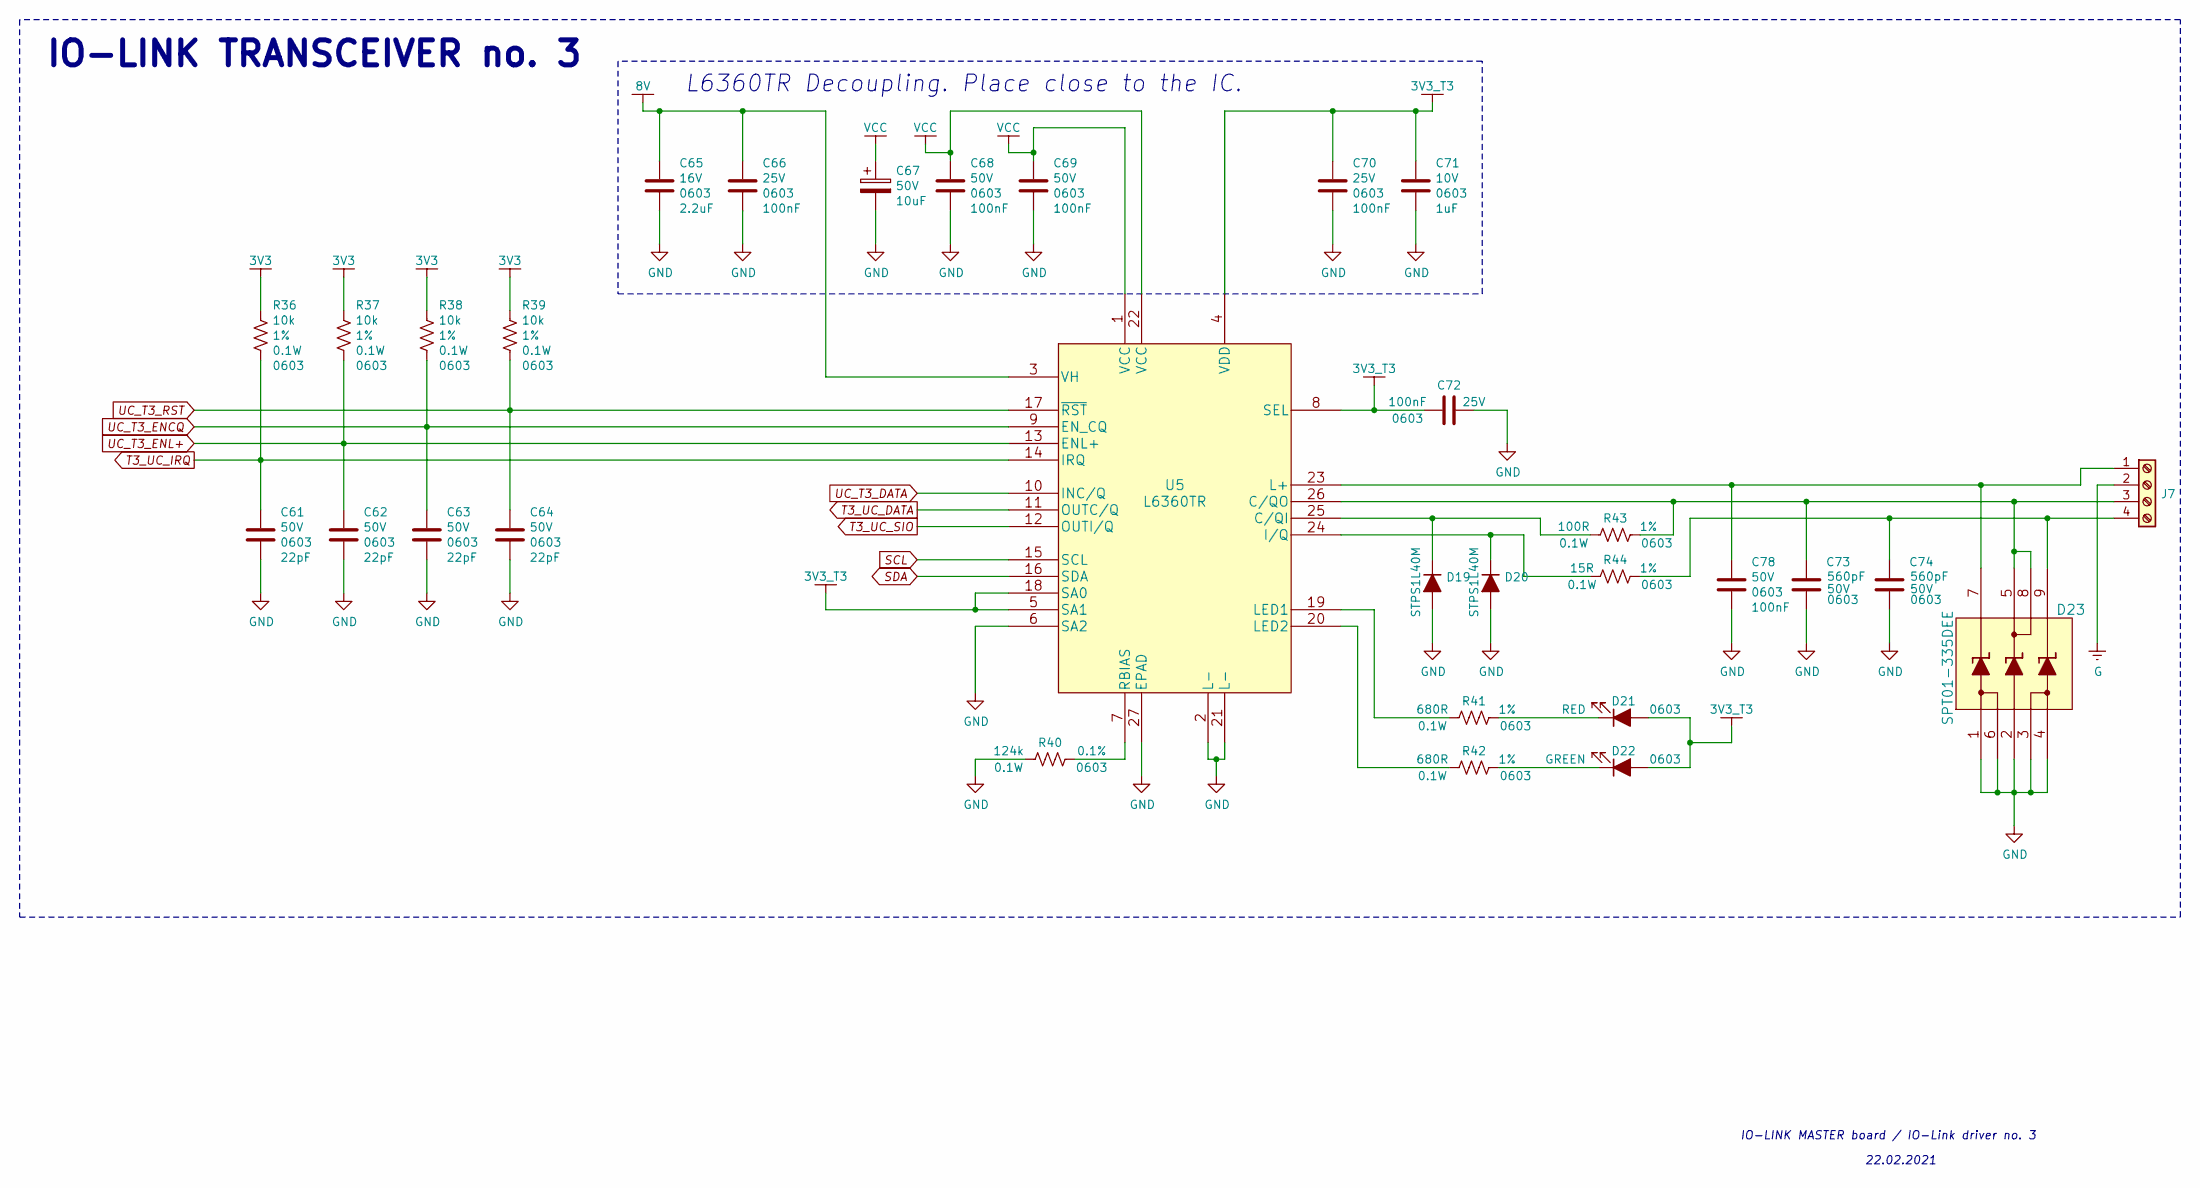
[picture p36: schematic IO_LINK_3.sch]

Parts:
C61, C62, C63, C64: 22pF_50V_0603; C_0603_1608Metric_Pad1.08x0.95mm_HandSolder; Voltage 50V; MPN CL10C220JB8NNNC; LCSC C1653
C65: 2.2uF_16V_0603; C_0603_1608Metric_Pad1.08x0.95mm_HandSolder; Voltage 16V; MPN CL10A225KO8NNNC; LCSC C23630
C66, C70, C72: 100nF_25V_0603; C_0603_1608Metric_Pad1.08x0.95mm_HandSolder; Voltage 25V; MPN 0603B104K250CT; LCSC C83054
C67: 10uF_50V_6.3mm_x_5.8mm_electrolytic; CP_Elec_6.3x5.8; Voltage 50V; MPN VZH100M1HTR-0606; LCSC C249820
C68, C69, C78: 100nF_50V_0603; C_0603_1608Metric_Pad1.08x0.95mm_HandSolder; Voltage 50V; MPN CC0603KRX7R9BB104; LCSC C14663
C71: 1uF_10V_0603; C_0603_1608Metric_Pad1.08x0.95mm_HandSolder; Voltage 10V; MPN CL10B105KP8NNNC; LCSC C95843
C73, C74: 560pF_50V_0603; C_0603_1608Metric_Pad1.08x0.95mm_HandSolder; Voltage 50V; MPN CL10B561KB8NNNC; LCSC C84721
D19, D20: STPS1L40M; DO-216; MPN STPS1L40M; LCSC N/A
D21: LED_RED; LED_0603; MPN 150060RS55040; LCSC N/A
D22: LED_GREEN; LED_0603; MPN 150060VS55040; LCSC N/A
D23: SPT01-335DEE; MPN SPT01-335DEE; LCSC N/A
J7: Screw_Terminal_01x04; TerminalBlock_Altech_AK300-4_P5.00mm; MPN 1715747; LCSC N/A
R36, R37, R38, R39: 10k_1%_0.1W_0603; R_0603_1608Metric_Pad0.98x0.95mm_HandSolder; Tolerance 1%; MPN 0603WAF1002T5E; LCSC C25804
R40: 124k_0.1%_0.1W_0603; R_0603_1608Metric_Pad0.98x0.95mm_HandSolder; Tolerance 0.1%; MPN RG1608P-1243-B-T5; LCSC N/A
R41, R42: 680R_1%_0.1W_0603; R_0603_1608Metric_Pad0.98x0.95mm_HandSolder; Tolerance 1%; MPN 0603WAF6800T5E; LCSC C23228
R43: 100R_1%_0.1W_0603; R_0603_1608Metric_Pad0.98x0.95mm_HandSolder; Tolerance 1%; MPN 0603WAF1000T5E; LCSC C22775
R44: 15R_1%_0.1W_0603; R_0603_1608Metric_Pad0.98x0.95mm_HandSolder; Tolerance 1%; MPN 0603WAF150JT5E; LCSC C22810
U5: L6360TR; MPN L6360TR; LCSC N/A

Connections:
3V3: R36.1, R37.1, R38.1, R39.1; also elsewhere on the board
3V3_T3: C70.1, C71.1, C72.2, D21.2 (A), D22.2 (A), U5.4 (VDD), U5.5 (SA1), U5.8 (SEL), U5.18 (SA0); also elsewhere on the board
8V: C65.1, C66.1, U5.3 (VH); also elsewhere on the board
G: J7.2; also elsewhere on the board
GND: C61.2, C62.2, C63.2, C64.2, C65.2, C66.2, C67.2, C68.2, C69.2, C70.2, C71.2, C72.1, C73.2, C74.2, C78.2, D19.2 (A), D20.2 (A), D23.1, D23.2, D23.3, D23.4, D23.6, R40.2, U5.2 (L-), U5.6 (SA2), U5.21 (L-), U5.27 (EPAD); also elsewhere on the board
unnamed: C73.1, D23.5, D23.8, J7.3, R43.1, U5.26 (C/QO)
unnamed: C74.1, D23.9, J7.4, R44.1
unnamed: C78.1, D23.7, J7.1, U5.23 (L+)
unnamed: D19.1 (K), R43.2, U5.25 (C/QI)
unnamed: D20.1 (K), R44.2, U5.24 (I/Q)
unnamed: D21.1 (K), R41.1
unnamed: D22.1 (K), R42.1
unnamed: R40.1, U5.7 (RBIAS)
unnamed: R41.2, U5.19 (LED1)
unnamed: R42.2, U5.20 (LED2)
SCL: U5.15 (SCL); also elsewhere on the board
SDA: U5.16 (SDA); also elsewhere on the board
T3_UC_DATA: U5.11 (OUTC/Q); also elsewhere on the board
T3_UC_IRQ: C61.1, R36.2, U5.14 (IRQ); also elsewhere on the board
T3_UC_SIO: U5.12 (OUTI/Q); also elsewhere on the board
UC_T3_DATA: U5.10 (INC/Q); also elsewhere on the board
UC_T3_ENCQ: C63.1, R38.2, U5.9 (EN_CQ); also elsewhere on the board
UC_T3_ENL+: C62.1, R37.2, U5.13 (ENL+); also elsewhere on the board
UC_T3_RST: C64.1, R39.2, U5.17 (~RST); also elsewhere on the board
VCC: C67.1, C68.1, C69.1, U5.1 (VCC), U5.22 (VCC); also elsewhere on the board

Notes on the sheet:
L6360TR Decoupling. Place close to the IC.
IO-LINK TRANSCEIVER no. 3
IO-LINK MASTER board / IO-Link driver no. 3
22.02.2021

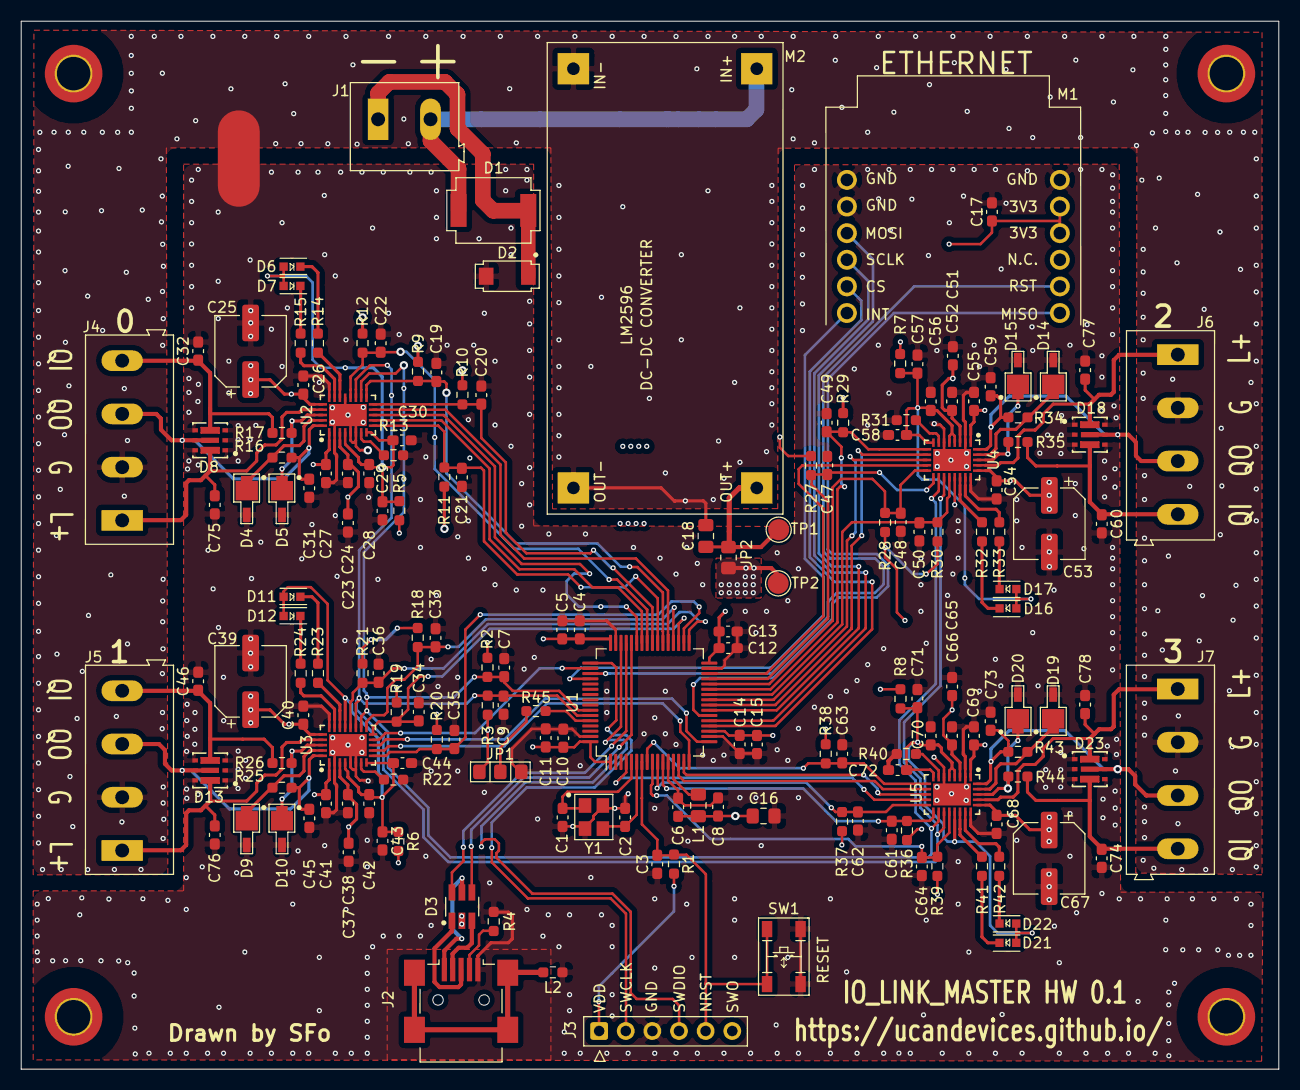
[picture p37: board IO_LINK.kicad_pcb from above]

Board: 4 copper layers, 120.0 x 100.0 mm, 172 parts (0 on the bottom side), 102 nets.
