ucandevices/IO-LINK-Covnerter/firmware/IOLINK_MASTER/IOLINK_MASTER.ioc

Mcu.UserName=STM32F072RBTx
PC10.Signal=GPIO_Output
PB14.GPIO_Label=UC_T1_ENL
PC0.GPIO_Label=UC_T3_ENCQ
PC6.GPIO_Label=T0_UC_SIO
PB0.GPIO_Label=UC_T2_RST
PB13.GPIO_Label=UC_T1_ENCQ
PB11.Signal=GPIO_Input
PB13.Signal=GPIO_Output
PB15.Signal=GPIO_Input
PC15-OSC32_OUT.GPIO_Label=T3_UC_SIO
PA15.GPIO_Label=T1_UC_SIO
PA12.Signal=USB_DP
PB6.Signal=I2C1_SCL
PC7.Signal=GPIO_Input
PC3.Signal=GPIO_Input
PB2.Signal=GPIO_Output
PB12.GPIO_Label=UC_T1_RST
PB1.GPIO_Label=UC_T2_ENCQ
PC11.GPIO_Label=INT_ETH
PB7.Signal=I2C1_SDA
PA8.Signal=GPIO_Output
PA0.Signal=USART4_TX
PB9.Signal=GPIO_Output
PB1.Signal=GPIO_Output
PA6.Signal=SPI1_MISO
PA10.Signal=USART1_RX
PA15.Signal=GPIO_Input
PC5.Signal=USART3_RX
PA4.GPIO_Label=CS_ETH
PC2.GPIO_Label=UC_T3_ENL
PF1-OSC_OUT.Signal=RCC_OSC_OUT
PA3.Signal=USART2_RX
PB3.GPIO_Label=L_ON
PB9.GPIO_Label=USB_ENABLE
PC10.GPIO_Label=RST_ETH
PC9.GPIO_Label=UC_T0_ENL
PC11.Signal=GPIO_Input
PC8.Signal=GPIO_Output
PC2.Signal=GPIO_Output
PC4.Signal=USART3_TX
PC6.Signal=GPIO_Input
PB11.GPIO_Label=T2_UC_SIO
PC0.Signal=GPIO_Output
PC8.GPIO_Label=UC_T0_ENCQ
PA13.Signal=SYS_SWDIO
PA8.GPIO_Label=UC_T0_RST
PB10.GPIO_Label=T2_UC_IRQ
PA9.Signal=USART1_TX
PC15-OSC32_OUT.Signal=GPIO_Input
PA1.Signal=USART4_RX
PB10.Signal=GPIO_Input
PB14.Signal=GPIO_Output
PA5.Signal=SPI1_SCK
PB15.GPIO_Label=T1_UC_IRQ
PC1.GPIO_Label=UC_T3_RST
PA2.Signal=USART2_TX
PC7.GPIO_Label=T0_UC_IRQ
PB3.Signal=GPIO_Output
PA4.Signal=GPIO_Output
PA11.Signal=USB_DM
PA14.Signal=SYS_SWCLK
PB2.GPIO_Label=UC_T2_ENL
PC3.GPIO_Label=T3_UC_IRQ
PC9.Signal=GPIO_Output
PF0-OSC_IN.Signal=RCC_OSC_IN
PB0.Signal=GPIO_Output
PC1.Signal=GPIO_Output
PB12.Signal=GPIO_Output
PA7.Signal=SPI1_MOSI
