ucandevices/IO-LINK-Covnerter/(commit log)

2021-03-03 Add files via upload
    First version of PCB board for IO-Link project. Minor (mostly esthetic) changes are still required, but the overall shape of the board and the schematic are has been finished.
    PCB is also free of relevant DRC bugs.
    [IO_LINK.kicad_pcb, IO_LINK.sch, IO_LINK_0.sch, IO_LINK_1.sch, IO_LINK_2.sch, IO_LINK_3.sch, Microcontroller.sch, Power_Supply.sch]
2021-03-06 Update Libs for PCb
    [ACT45B.step, COIL_SMD_0805.STEP, CRYSTAL_SMD_4pads_3.2x2.5.step, Capacitor_0603.step, Capacitor_0805.step, Capacitor_1206.step, Coilcraft-MSS1210.step, Crystal_SMD.STEP]
2021-06-21 Add test software
    [IOLINK_MASTER Debug.cfg]
2021-06-21 PCB Release
    [CAN.sch, Ethernet.sch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]
