ucandevices/IO-LINK-Covnerter/(notices)

Notices in the files:
firmware/IOLINK_MASTER/Core/Inc/main.h:
This software component is licensed by ST under BSD 3-Clause license,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
